TLDSJPWORK/1000base-t1-converter/case/README.md

# 1000BASE-T1コンバーター ケース

125 × 70 mm基板用の上下分割ケースです。
設計外形は132.8 × 77.8 × 28.0 mmです。

## 造形・組立

PLA、0.4 mmノズル、0.2 mm積層で造形しました。
上下ケースはM3×25 mmねじ4本とM3ナット4個で固定します。

上ケースの造形には、ふたの外面を下に配置した
`case-top-print-oriented.stl`を使用してください。
実際に使うねじ・ナットと造形条件で寸法を確認してください。

## ファイル

| ファイル | 用途 |
| --- | --- |
| [case-bottom.stl](case-bottom.stl) | 下ケースの造形 |
| [case-top-print-oriented.stl](case-top-print-oriented.stl) | 上ケースの造形 |
| [case-top.stl](case-top.stl) | 組立時の位置・向きに配置した上ケース形状 |
| [case-bottom.step](case-bottom.step) / [case-top.step](case-top.step) | 他CADでの編集・参照 |

## ライセンス

JP WORKS作成のケース形状をCC BY 4.0で提供します。

第三者の部品参照モデルを含むFreeCADファイル、実装基板STEP、
メーカー由来の部品STEPは、この公開データに含めていません。
