TLDSJPWORK/1000base-t1-converter/production/README.md

# 製造データ

Rev1.0の基板製作に使用したデータです。対応するKiCadソースは[hardware/](../hardware/)にあります。

| ファイル | 内容 |
| --- | --- |
| [1000base-t1-conv.zip](1000base-t1-conv.zip) | Gerber・ドリル出力 |
| [bom.csv](bom.csv) | BOM（部品表） |
| [positions.csv](positions.csv) | 実装位置データ（CPL） |

再製造する場合は、部品指定や未実装部品についての[既知事項](../docs/rev1.0-known-issues.md)を確認してください。
