TLDSJPWORK/1000base-t1-converter/adapter/production/README.md

# MATEnetアダプタ 製造データ

基板Rev1の製造データです。

| ファイル | 内容 |
| --- | --- |
| [Gerber-JLCPCB-rev1.zip](Gerber-JLCPCB-rev1.zip) | Gerber・ドリル出力 |
| [BOM-JLCPCB.csv](BOM-JLCPCB.csv) | JLCPCB実装用部品表。J1のみ |
| [CPL-JLCPCB.csv](CPL-JLCPCB.csv) | J1の実装位置 |

J1はTE Connectivity 2304372-1（LCSC：C5157090）です。J2へのツイストペア線と本体側プラグは手作業で取り付けるため、実装用BOM・位置データには含まれません。

シルクの一部は基板端やソルダーマスク開口に重なる配置です。意図した配置であり、製造時には重なる部分が切り取られます。
