TLDSJPWORK/1000base-t1-converter/production/bom.csv

Designator | Footprint | Quantity | Value | LCSC Part #
C201, C202, C203, C204, C211, C213, C215, C216, C217, C220, C221, C225, C304, C306, C308, C310, C314, C316, C320, C322, C324, C401, C407, C501, C502, C503, C504, C601, C602, C603, C604, C605, C606, C607, C609, C610, C614, C617 | C0603 | 38 | 0.1uF | C14663
C205 | C1206 | 1 | 1kV 4700pF | C9192
C206, C207 | C0603 | 2 | 50V 22pF | C326840
C208, C209, C218, C222, C223, C227, C228, C301, C311, C317 | C0603 | 10 | 10V 10uF | C237435
C210, C224, C302, C312, C318, C405, C406, C608, C611 | C0603 | 9 | 1uF | C15849
C212, C214, C226, C303, C305, C307, C309, C313, C315, C319, C321, C323 | C0603 | 12 | 50V 0.01uF | C57112
C219, C402 | C0603 | 2 | 25V 10uF | C96446
C403, C408, C613 | C0603 | 3 | 2.2uF | C307463
C404, C409 | C0805 | 2 | 47uF | C124129
C505, C612 | C1206 | 2 | 1kV 0.01uF | C107192
C615, C616 | C0603 | 2 | 27pF | C107045
CN201 | CONN-TH_WJ2EDGR-5.08-2P | 1 | WJ2EDGR-5.08-2P | C8383
D401, D403 | SMA_L4.3-W2.6-LS5.2-RD | 2 | B160-13-F | C24784
D402, U201, U202, U204 | LED0603-RD_GREEN | 4 | PSC-1608U52GC-G4 | C22371297
D601 | SOD-123F_L2.8-W1.8-LS3.7-RD | 1 | MBR120VLSFT1G | C223608
J601 | PinSocket_2x20_P2.54mm_Vertical | 1 | Conn_02x20_Counter_Clockwise
J602 | PinHeader_1x03_P2.54mm_Vertical | 1 | Conn_01x03_Pin
L201 | FILTER-SMD_4P-L3.2-W2.5-BL_DLW32SH510XK2L | 1 | DLW32MH201XK2L | C883600
L202, L203, L204, L301, L302, L303 | L0603 | 6 | BLM18KG102BH1D | C560058
L401, L402 | IND-SMD_L7.1-W6.6 | 2 | 15uH | C149585
LED601 | LED0603-RD_GREEN | 1 | TJ-S1608CY6T5ALC7K-A5 | C440520
LED602 | LED0603-RD_RED | 1 | XL-1608SURC-06 | C965799
R201, R202, R207, R209, R212, R213, R301, R614 | R0603 | 8 | 2.2k | C4190
R203, R204, R208, R211, R504 | R0603 | 5 | 2.49k | C22908
R205, R206 | R0603 | 2 | 1.0k 0.25W | C2653986
R210, R505, R607, R613 | R1206 | 4 | 1M 0.25W | C108083
R214, R215, R217, R218, R220, R221, R302, R304, R305, R306, R307, R308, R608, R609 | R0603 | 14 | 22 | C108405
R216 | R0603 | 1 | 100 | C22775
R219, R604 | R0603 | 2 | 10.0k | C25804
R222, R610, R615 | R0603 | 3 | 1k | C21190
R303 | R0603 | 1 | 11k | C137801
R401 | R0603 | 1 | 1.30k | C705951
R402 | R0603 | 1 | 3.40k | C705984
R403 | R0603 | 1 | 4.42k | C728617
R404, R407 | R0603 | 2 | 1.02k | C705819
R405 | R0603 | 1 | 22k | C31850
R406 | R0603 | 1 | 2.26k | C861811
R501 | R0603 | 1 | 5.76k | C23070
R502, R503, R612 | R0603 | 3 | 470 | C23179
R601, R603 | R1206 | 2 | 5.1k | C163372
R602 | R0603 | 1 | 5.6k | C23189
R605, R606 | R0603 | 2 | 27 | C137753
R611 | R0603 | 1 | DNF
RJ501 | RJ45-TH_HR911130A | 1 | HR911130A | C54408
SW601, SW602 | SW-SMD_L6.0-W3.3-LS8.0 | 2 | TS-1101-C-W | C318938
U203, U205 | SW-TH_4P-P2.54_SMQP-02R-TP | 2 | SMQP-02R-TP | C5299482
U206 | UQFN-36_L6.0-W6.0-P0.50-BL-EP3.7 | 1 | DP83TG720RWRHATQ1 | C2921292
U207 | CRYSTAL-SMD_4P-L3.2-W2.5-BL | 1 | ABM8AIG-25.000MHZ-12-2Z-T3 | C1985412
U208 | HVSSOP-8_L3.0-W3.0-P0.65-LS4.9-BL-EP | 1 | TPS7B8233QDGNRQ1 | C5220182
U301 | VQFN-48_L7.0-W7.0-P0.50-BL-EP4.1 | 1 | DP83867ERGZR | C913839
U302, U303 | C0603 | 2 | 25V 27pF | C1656
U401, U403 | SOT-23-6_L2.9-W1.6-P0.95-LS2.8-BR | 2 | LMR14206XMKX/NOPB | C48239
U402 | VSON-10_L3.0-W3.0-P0.50-TL-EP | 1 | TPS74701DRCR | C105262
U601 | LQFN-56_L7.0-W7.0-P0.4-EP | 1 | RP2040 | C2040
U602 | USON-8_L3.0-W2.0-P0.50-BL-EP | 1 | W25Q16JVUXIQ | C2843335
U603 | CRYSTAL-SMD_L11.5-W4.8-LS12.7 | 1 | ABLS-12.000MHZ-B4-T | C596818
U604 | SOT-23-5_L2.9-W1.6-P0.95-LS2.8-BR | 1 | TPS3838K33QDBVRQ1 | C702198
USB601 | USB-C-SMD_TYPE-C-6PIN-2MD-073 | 1 | TYPE-C 16PIN 2MD(073) | C2765186
X301 | OSC-SMD_L5.0-W3.2 | 1 | NX5032GA-25.000M-STD-CSK-4 | C115092
