TLDSJPWORK/1000base-t1-converter/adapter/production/BOM-JLCPCB.csv

Comment | Designator | Footprint | LCSC Part #
TE 2304372-1 | J1 | TE_MATEnet_2304372-1_C5157090 | C5157090
