TLDSJPWORK/1000base-t1-converter/adapter/case/case-top-print-oriented.stl

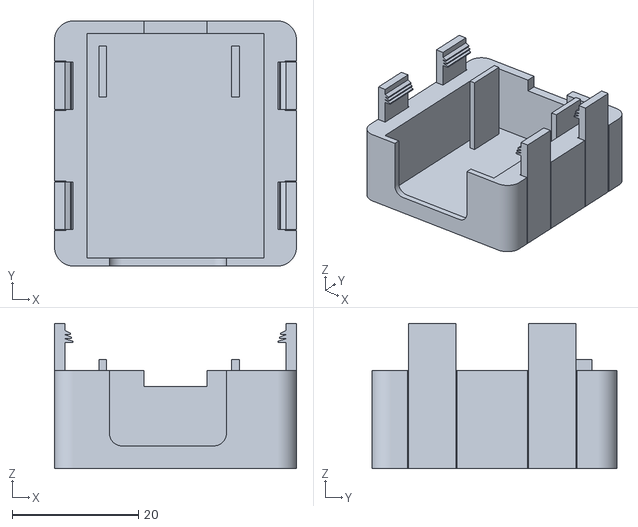
[picture p7: CAD file, 2026-10-27]
adapter/case/case-top-print-oriented.stl
38.3 x 38.8 x 23.0
