TLDSJPWORK/1000base-t1-converter/case/case-bottom.step

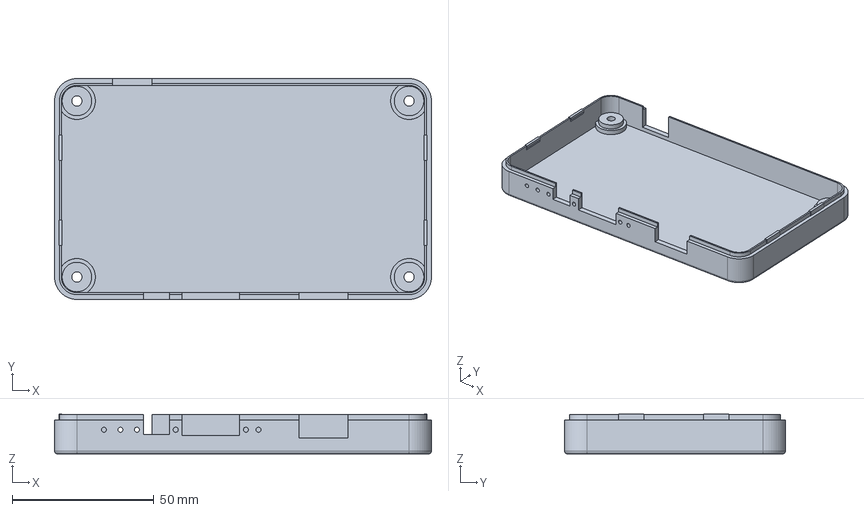
[picture p8: CAD file, 2026-10-27]
case/case-bottom.step
132.8 x 77.8 x 14.0 mm
