TLDSJPWORK/1000base-t1-converter/case/case-top-print-oriented.stl

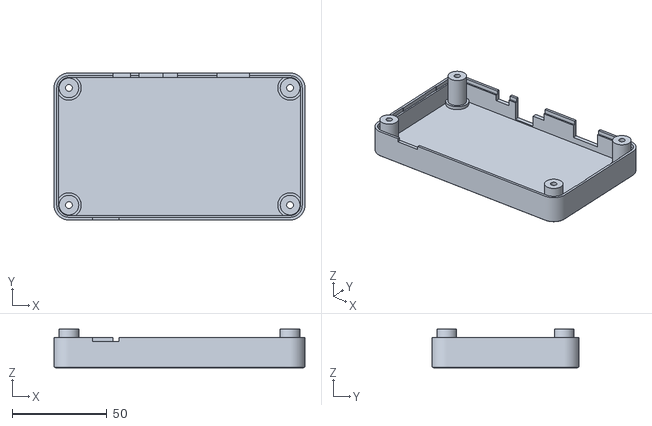
[picture p9: CAD file, 2026-10-27]
case/case-top-print-oriented.stl
132.8 x 77.8 x 20.4
