TLDSJPWORK/1000base-t1-converter/adapter/case/case-bottom.step

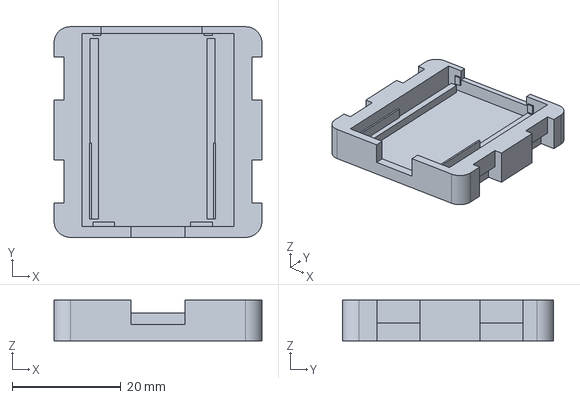
[picture p10: CAD file, 2026-10-27]
adapter/case/case-bottom.step
38.3 x 38.8 x 7.50 mm
