TLDSJPWORK/1000base-t1-converter/(list of files, cad)

Other CAD files:
adapter/case/case-top.step
case/case-top.step
adapter/case/case-bottom.stl
adapter/case/case-top.stl
case/case-bottom.stl
case/case-top.stl
