TLDSJPWORK/1000base-t1-converter/docs/1000base-t1-converter_schematic.pdf

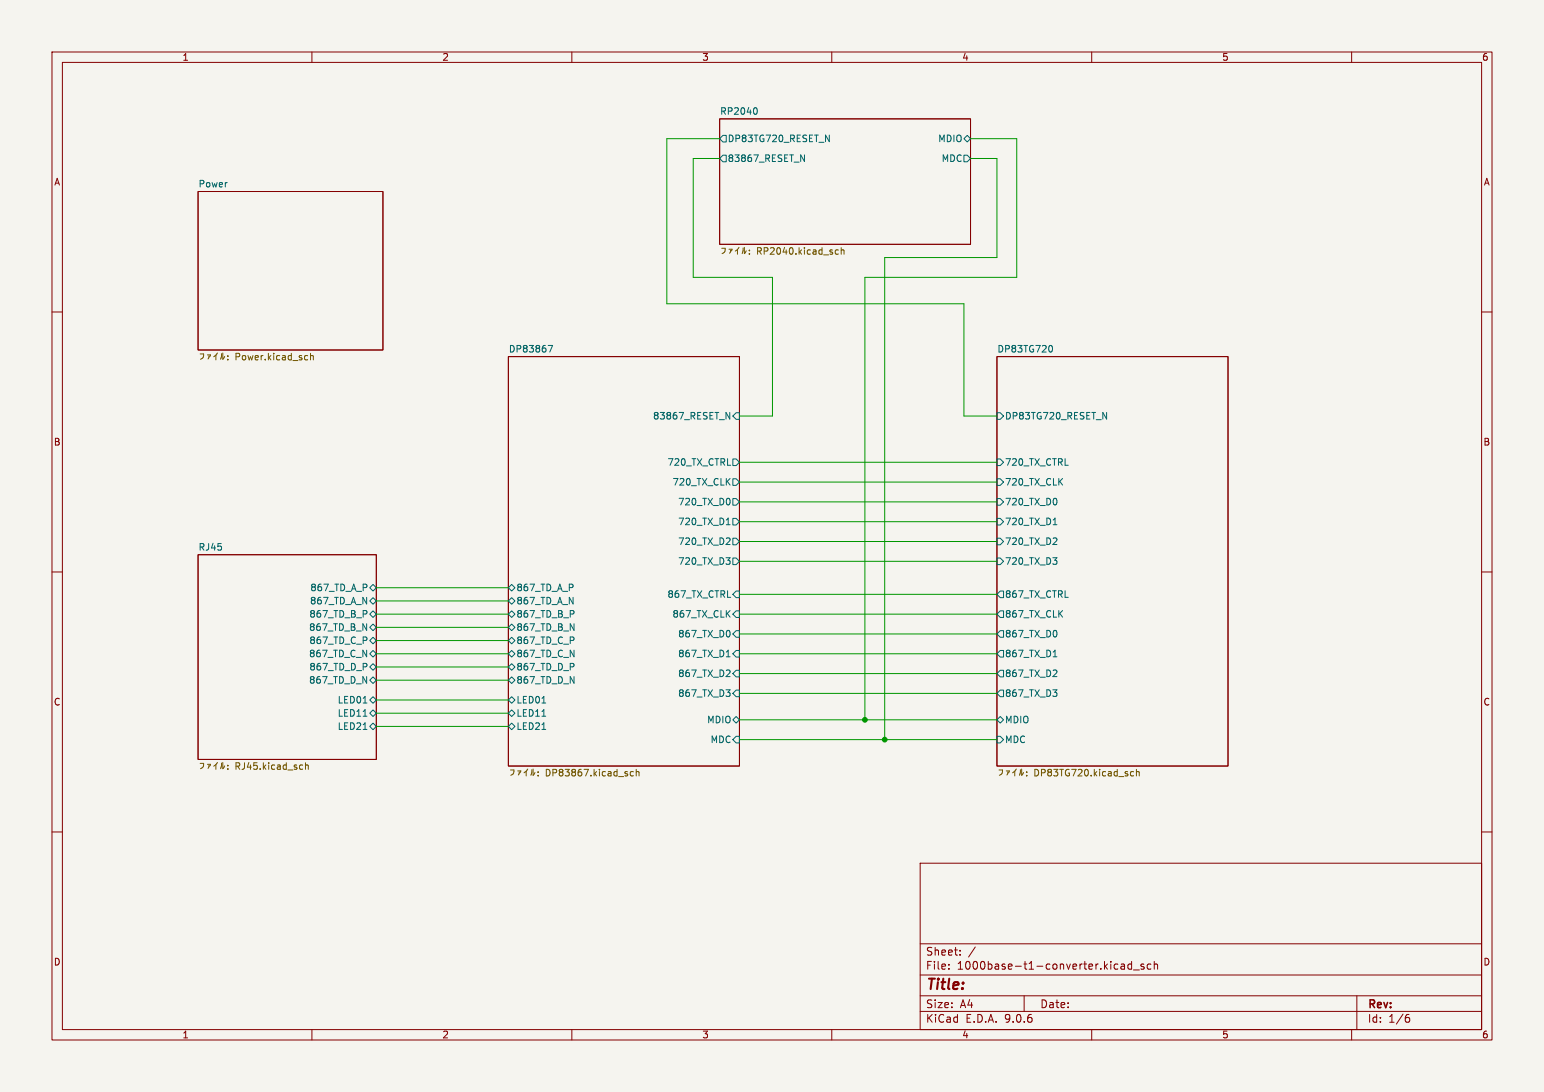
[picture p11: page 1]

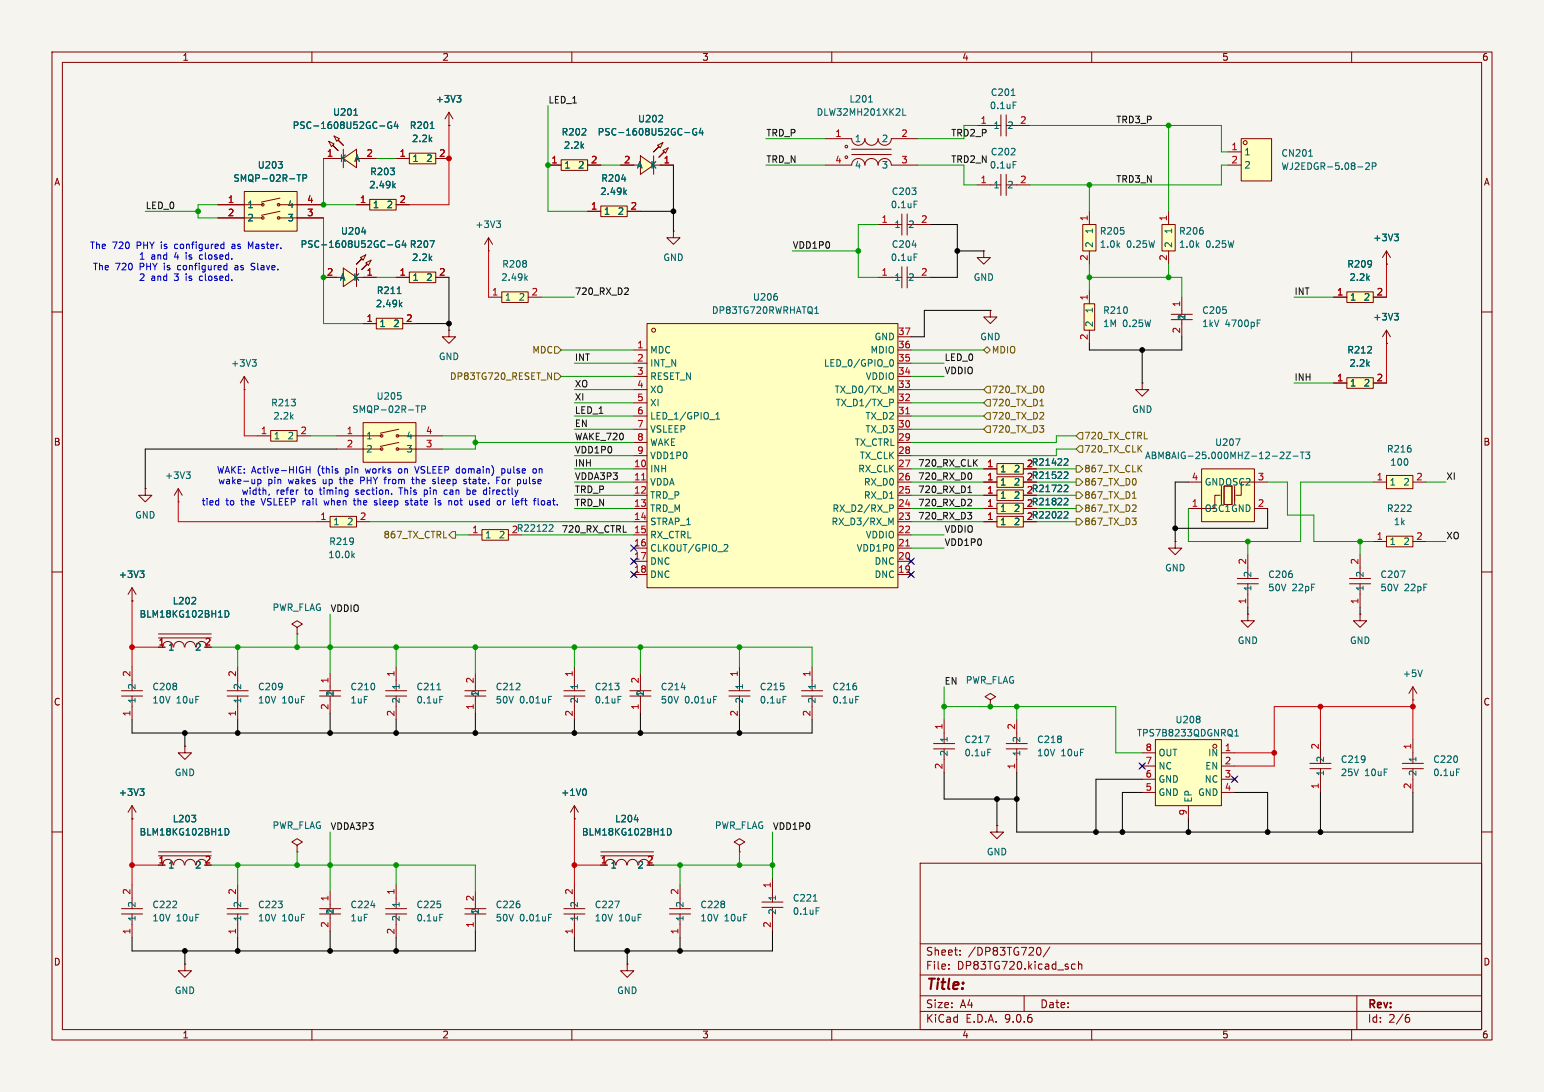
[picture p12: page 2]

LED_0/GPIO_0 35 VDDIO 34 TX_D0/TX_M 33 TX_D1/TX_P 32 TX_D2 31 TX_D3 30 TX_CTRL 29 TX_CLK 28 RX_CLK 27 RX_D0 26 RX_D1 25 RX_D2/RX_P 24 RX_D3/RX_M 23 VDDIO 22 VDD1P0 21 DNC 20 DNC 19 U206 DP83TG720RWRHATQ1

9 OUT 8 NC 7 GND 6 GND 5 U208 TPS7B8233QDGNRQ1

IN 1 EN 2 NC 3 GND 4 EP

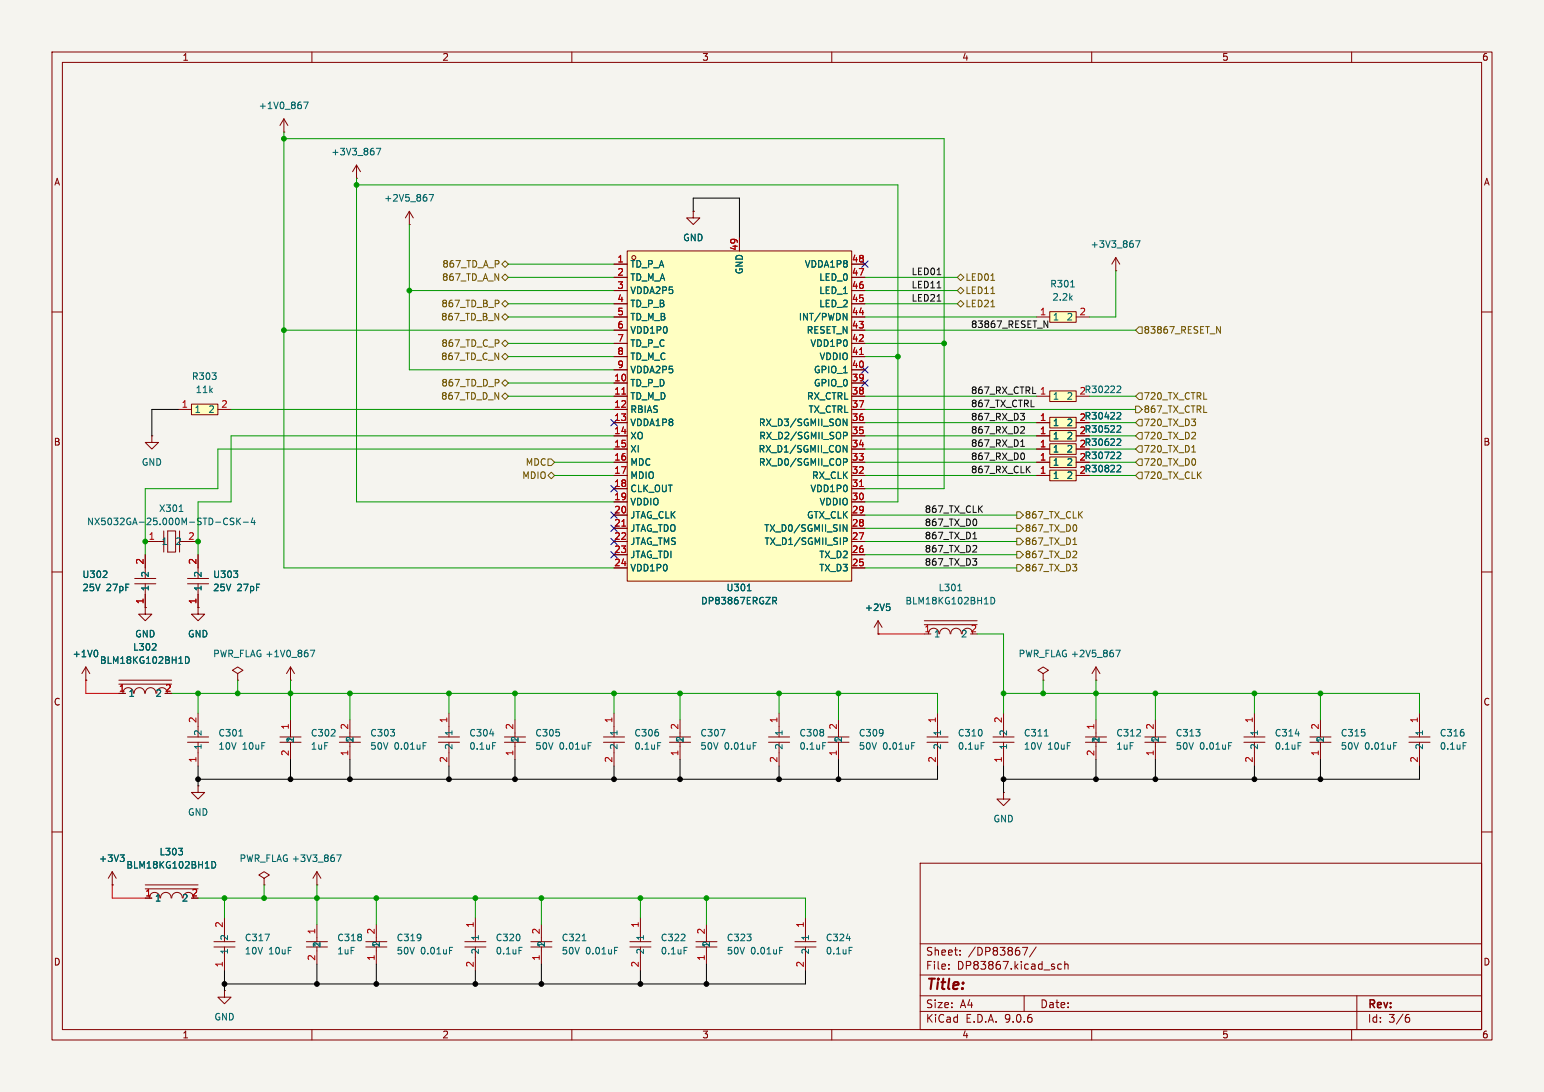
[picture p13: page 3]

GND
TD_P_A 1 TD_M_A 2 VDDA2P5 3 TD_P_B 4 TD_M_B 5 VDD1P0 6 TD_P_C 7 TD_M_C 8 VDDA2P5 9 TD_P_D 10 TD_M_D 11 RBIAS 12 VDDA1P8 13 XO 14 XI 15 MDC 16 MDIO 17 CLK_OUT 18 VDDIO 19

INT/PWDN 44 RESET_N 43 VDD1P0 42 VDDIO 41 GPIO_1 40 GPIO_0 39 RX_CTRL 38 TX_CTRL 37 RX_D3/SGMII_SON 36 RX_D2/SGMII_SOP 35 RX_D1/SGMII_CON 34 RX_D0/SGMII_COP 33 RX_CLK 32 VDD1P0 31 VDDIO 30 GTX_CLK 29 TX_D0/SGMII_SIN 28 TX_D1/SGMII_SIP 27 TX_D2 26 TX_D3 25 GND

INT/PWDN 44 RESET_N 43 VDD1P0 42 VDDIO 41 GPIO_1 40 GPIO_0 39 RX_CTRL 38 TX_CTRL 37 RX_D3/SGMII_SON 36 RX_D2/SGMII_SOP 35 RX_D1/SGMII_CON 34 RX_D0/SGMII_COP 33 RX_CLK 32 VDD1P0 31 VDDIO 30 GTX_CLK 29 TX_D0/SGMII_SIN 28 TX_D1/SGMII_SIP 27 TX_D2 26 TX_D3 25 U301 DP83867ERGZR GND

Id: 3/6 Title: File: DP83867.kicad_sch Sheet: /DP83867/

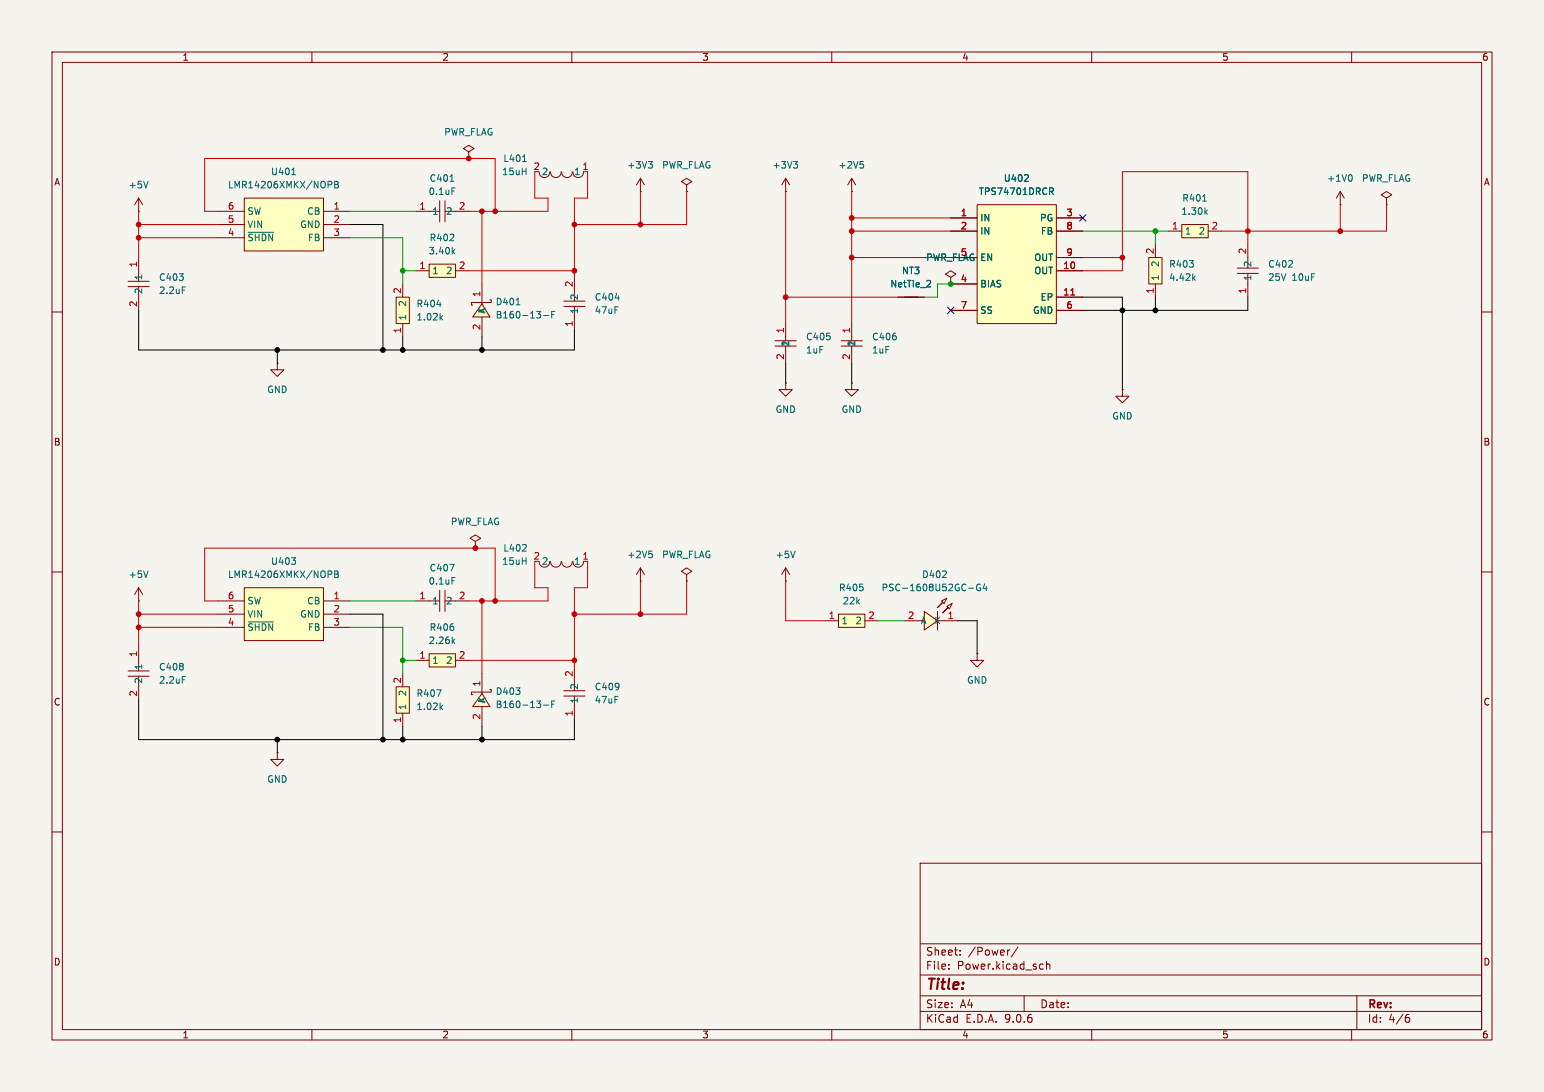
[picture p14: page 4]

Id: 4/6 Title: File: Power.kicad_sch Sheet: /Power/ 1

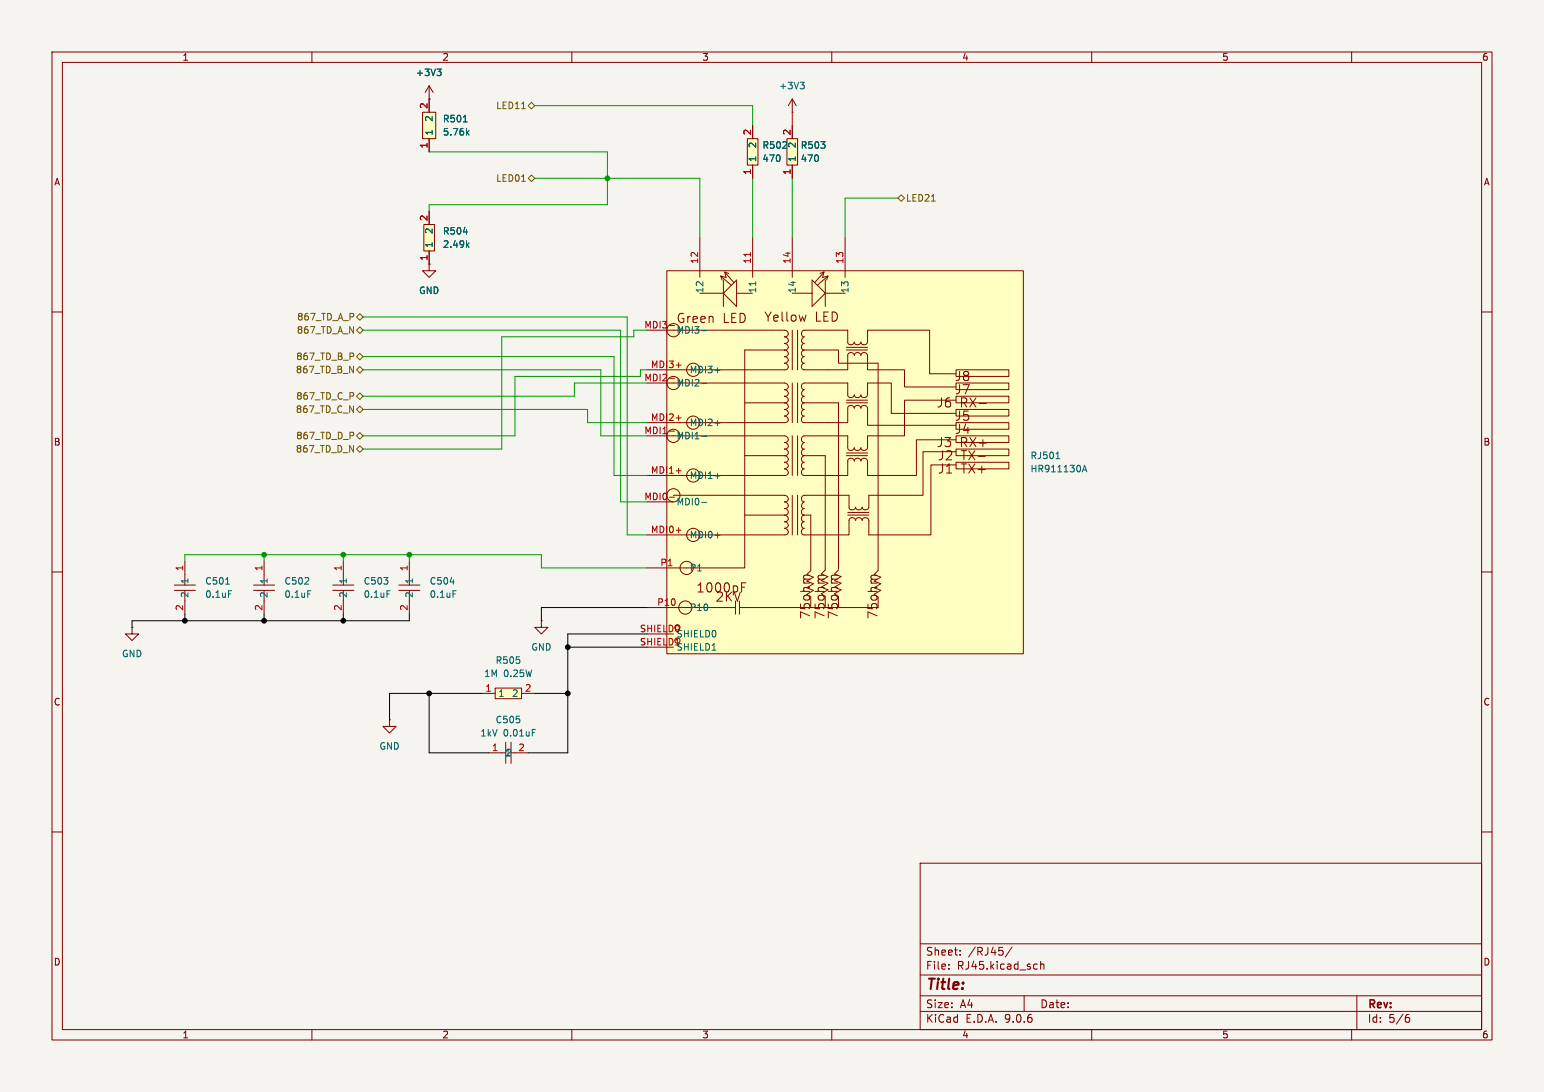
[picture p15: page 5]

Id: 5/6 Title: File: RJ45.kicad_sch Sheet: /RJ45/

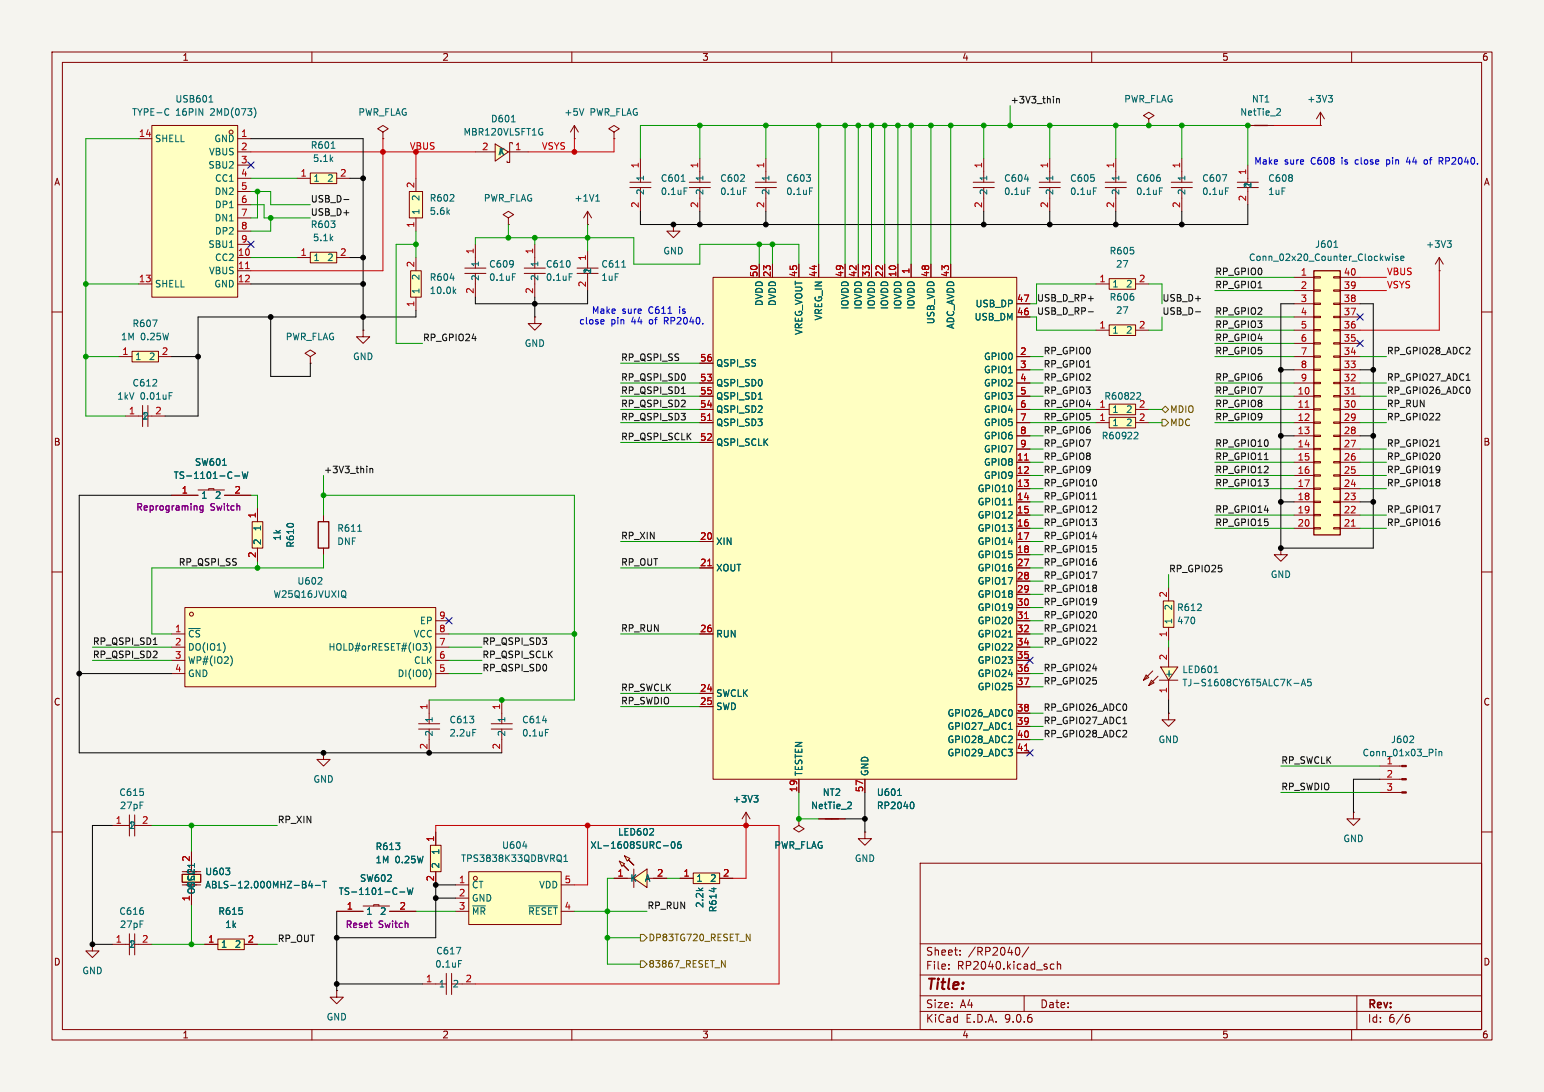
[picture p16: page 6]

Make sure C608 is close pin 44 of RP2040. Make sure C611 is

Id: 6/6 Title: File: RP2040.kicad_sch Sheet: /RP2040/
