TLDSJPWORK/1000base-t1-converter/hardware/1000base-t1-converter.kicad_pcb

## KiCad design hardware/1000base-t1-converter.kicad_pcb (2026-10-04)

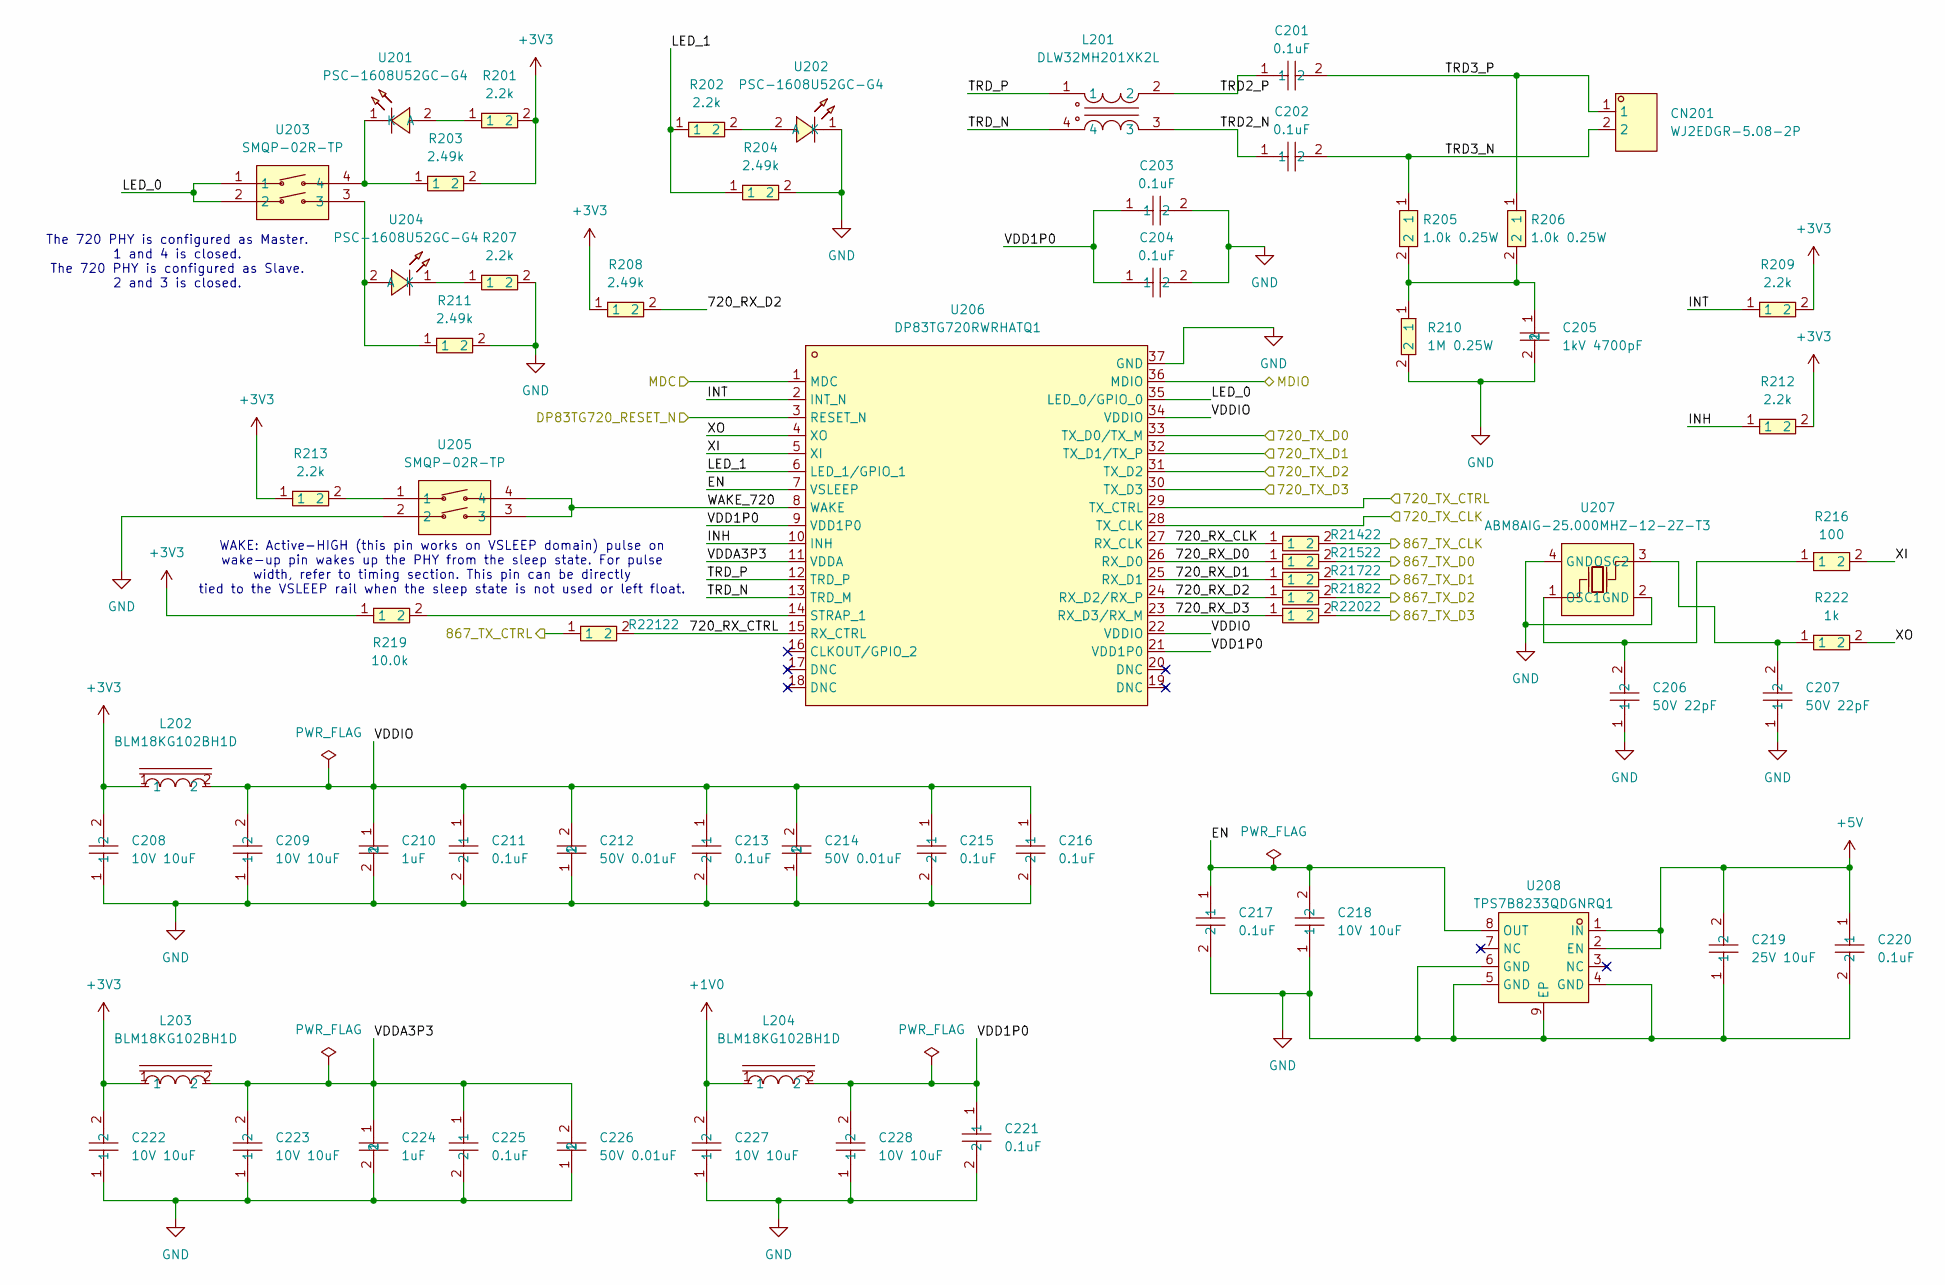
[picture p17: schematic DP83TG720.kicad_sch]

Parts:
C201, C202, C203, C204, C211, C213, C215, C216, C217, C220, C221, C225: 0.1uF; C0603; LCSC Part C14663
C205: 1kV 4700pF; C1206; LCSC Part C9192
C206, C207: 50V 22pF; C0603; LCSC Part C326840
C208, C209, C218, C222, C223, C227, C228: 10V 10uF; C0603; MPN GRM188Z71A106MA73D; LCSC Part C237435
C210, C224: 1uF; C0603; LCSC Part C15849
C212, C214, C226: 50V 0.01uF; C0603; LCSC Part C57112
C219: 25V 10uF; C0603; LCSC Part C96446
CN201: WJ2EDGR-5.08-2P; CONN-TH_WJ2EDGR-5.08-2P; MPN WJ2EDGR-5.08-02P-14-00A; LCSC Part C8383
L201: DLW32MH201XK2L; FILTER-SMD_4P-L3.2-W2.5-BL_DLW32SH510XK2L; MPN DLW32MH201XK2L; LCSC Part C883600
L202, L203, L204: BLM18KG102BH1D; L0603; MPN BLM18KG102BH1D; LCSC Part C560058
R201, R202, R207, R209, R212, R213: 2.2k; R0603; LCSC Part C4190
R203, R204, R208, R211: 2.49k; R0603; LCSC Part C22908
R205, R206: 1.0k 0.25W; R0603; LCSC Part C2653986
R210: 1M 0.25W; R1206; LCSC Part C108083
R214, R215, R217, R218, R220, R221: 22; R0603; LCSC Part C108405
R216: 100; R0603; LCSC Part C22775
R219: 10.0k; R0603; LCSC Part C25804
R222: 1k; R0603; LCSC Part C21190
U201, U202, U204: PSC-1608U52GC-G4; LED0603-RD_GREEN; LCSC Part C22371297
U203, U205: SMQP-02R-TP; SW-TH_4P-P2.54_SMQP-02R-TP; LCSC Part C5299482
U206: DP83TG720RWRHATQ1; UQFN-36_L6.0-W6.0-P0.50-BL-EP3.7; MPN DP83TG720RWRHATQ1; LCSC Part C2921292
U207: ABM8AIG-25.000MHZ-12-2Z-T3; CRYSTAL-SMD_4P-L3.2-W2.5-BL; MPN ABM8AIG-25.000MHZ-12-2Z-T3; LCSC Part C1985412
U208: TPS7B8233QDGNRQ1; HVSSOP-8_L3.0-W3.0-P0.65-LS4.9-BL-EP; MPN TPS7B8233QDGNRQ1; LCSC Part C5220182

Connections:
+1V0: C227.2, L204.1; also elsewhere on the board
+3V3: C208.2, C222.2, L202.1, L203.1, R201.2, R203.2, R208.1, R209.2, R212.2, R213.1, R219.1; also elsewhere on the board
+5V: C219.2, C220.1, U208.1 (IN), U208.2 (EN); also elsewhere on the board
/DP83TG720/720_RX_CLK: R214.1, U206.27 (RX_CLK)
/DP83TG720/720_RX_CTRL: R221.2, U206.15 (RX_CTRL)
/DP83TG720/720_RX_D0: R215.1, U206.26 (RX_D0)
/DP83TG720/720_RX_D1: R217.1, U206.25 (RX_D1)
/DP83TG720/720_RX_D2: R208.2, R218.1, U206.24 (RX_D2/RX_P)
/DP83TG720/720_RX_D3: R220.1, U206.23 (RX_D3/RX_M)
/DP83TG720/EN: C217.1, C218.2, U206.7 (VSLEEP), U208.8 (OUT)
/DP83TG720/INH: R212.1, U206.10 (INH)
/DP83TG720/INT: R209.1, U206.2 (INT_N)
/DP83TG720/LED_0: U203.1, U203.2, U206.35 (LED_0/GPIO_0)
/DP83TG720/LED_1: R202.1, R204.1, U206.6 (LED_1/GPIO_1)
/DP83TG720/TRD2_N: C202.1, L201.3
/DP83TG720/TRD2_P: C201.1, L201.2
/DP83TG720/TRD3_N: C202.2, CN201.2, R205.1
/DP83TG720/TRD3_P: C201.2, CN201.1, R206.1
/DP83TG720/TRD_N: L201.4, U206.13 (TRD_M)
/DP83TG720/TRD_P: L201.1, U206.12 (TRD_P)
/DP83TG720/VDD1P0: C203.1, C204.1, C221.1, C228.2, L204.2, U206.9 (VDD1P0), U206.21 (VDD1P0)
/DP83TG720/VDDA3P3: C223.2, C224.1, C225.1, C226.2, L203.2, U206.11 (VDDA)
/DP83TG720/VDDIO: C209.2, C210.1, C211.1, C212.2, C213.1, C214.2, C215.1, C216.1, L202.2, U206.22 (VDDIO), U206.34 (VDDIO)
/DP83TG720/WAKE_720: U205.3, U205.4, U206.8 (WAKE)
/DP83TG720/XI: R216.2, U206.5 (XI)
/DP83TG720/XO: R222.2, U206.4 (XO)
/DP83867/720_TX_CLK: U206.28 (TX_CLK); also elsewhere on the board
/DP83867/720_TX_CTRL: U206.29 (TX_CTRL); also elsewhere on the board
/DP83867/720_TX_D0: U206.33 (TX_D0/TX_M); also elsewhere on the board
/DP83867/720_TX_D1: U206.32 (TX_D1/TX_P); also elsewhere on the board
/DP83867/720_TX_D2: U206.31 (TX_D2); also elsewhere on the board
/DP83867/720_TX_D3: U206.30 (TX_D3); also elsewhere on the board
/DP83867/867_TX_CLK: R214.2; also elsewhere on the board
/DP83867/867_TX_CTRL: R221.1; also elsewhere on the board
/DP83867/867_TX_D0: R215.2; also elsewhere on the board
/DP83867/867_TX_D1: R217.2; also elsewhere on the board
/DP83867/867_TX_D2: R218.2; also elsewhere on the board
/DP83867/867_TX_D3: R220.2; also elsewhere on the board
/DP83867/83867_RESET_N: U206.3 (RESET_N); also elsewhere on the board
/DP83867/MDC: U206.1 (MDC); also elsewhere on the board
/DP83867/MDIO: U206.36 (MDIO); also elsewhere on the board
GND: C203.2, C204.2, C205.2, C206.1, C207.1, C208.1, C209.1, C210.2, C211.2, C212.1, C213.2, C214.1, C215.2, C216.2, C217.2, C218.1, C219.1, C220.2, C221.2, C222.1, C223.1, C224.2, C225.2, C226.1, C227.1, C228.1, R204.2, R207.2, R210.2, R211.2, U202.1 (K), U205.2, U206.37 (GND), U207.2 (GND), U207.4 (GND), U208.4 (GND), U208.5 (GND), U208.6 (GND), U208.9 (EP); also elsewhere on the board
unnamed: C205.1, R205.2, R206.2, R210.1
unnamed: R213.2, U205.1
unnamed: R201.1, U201.2 (A)
unnamed: R203.1, U201.1 (K), U203.4
unnamed: R202.2, U202.2 (A)
unnamed: R211.1, U203.3, U204.2 (A)
unnamed: R207.1, U204.1 (K)
unnamed: R219.2, U206.14 (STRAP_1)
unnamed: C206.2, R216.1, U207.1 (OSC1)
unnamed: C207.2, R222.1, U207.3 (OSC2)

Notes on the sheet:
The 720 PHY is configured as Master. 1 and 4 is closed. The 720 PHY is configured as Slave. 2 and 3 is closed.
WAKE: Active-HIGH (this pin works on VSLEEP domain) pulse on wake-up pin wakes up the PHY from the sleep state. For pulse width, refer to timing section. This pin can be directly tied to the VSLEEP rail when the sleep state is not used or left float.

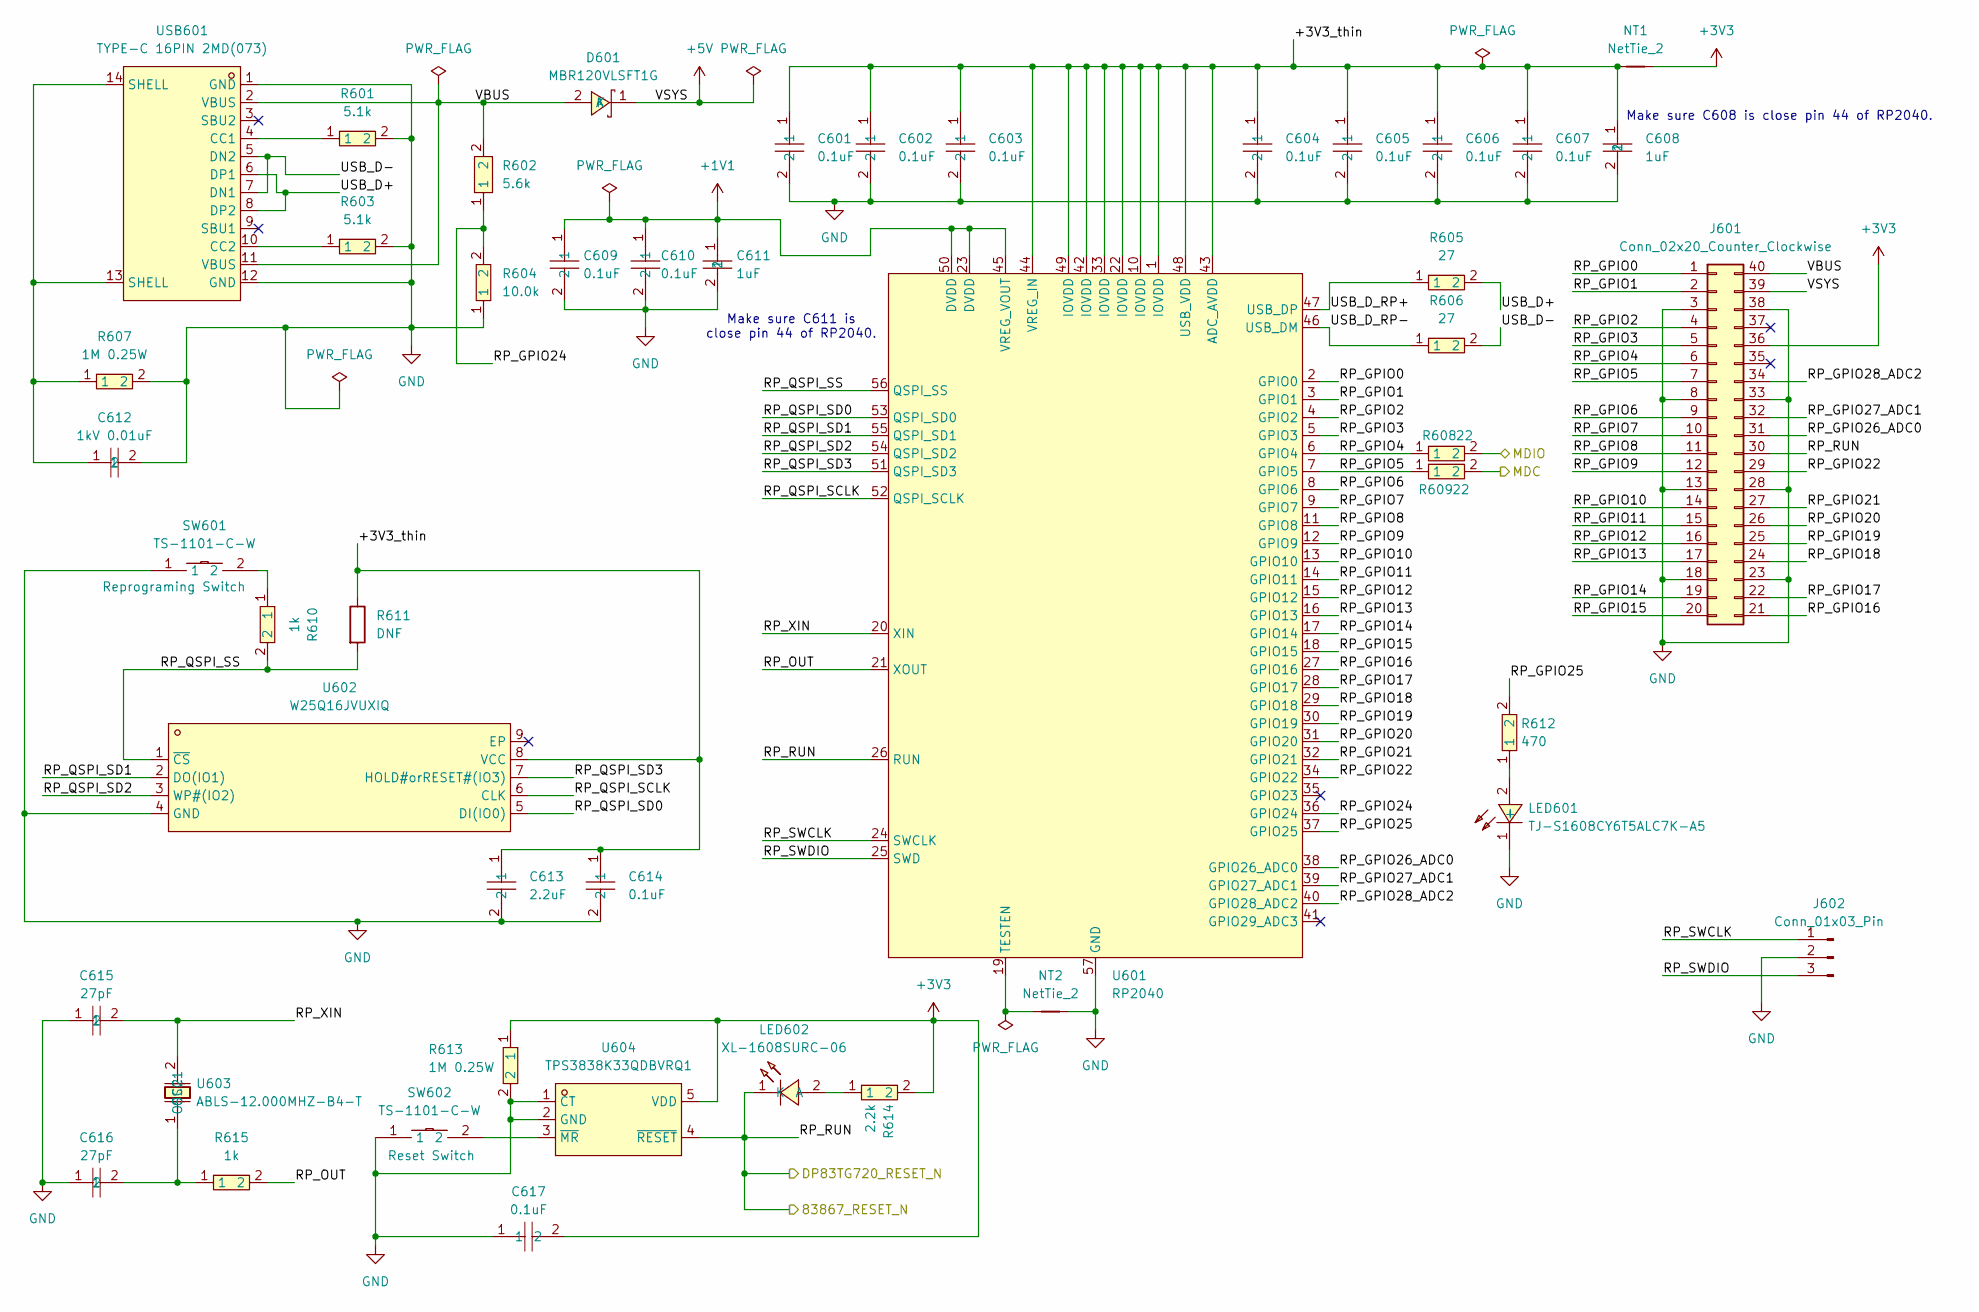
[picture p18: schematic RP2040.kicad_sch]

Parts:
C601, C602, C603, C604, C605, C606, C607, C609, C610, C614, C617: 0.1uF; C0603; LCSC Part C14663
C608, C611: 1uF; C0603; LCSC Part C15849
C612: 1kV 0.01uF; C1206; LCSC Part C107192
C613: 2.2uF; C0603; LCSC Part C307463
C615, C616: 27pF; C0603; LCSC Part C107045
D601: MBR120VLSFT1G; SOD-123F_L2.8-W1.8-LS3.7-RD; LCSC Part C223608
J601: Conn_02x20_Counter_Clockwise; PinSocket_2x20_P2.54mm_Vertical
J602: Conn_01x03_Pin; PinHeader_1x03_P2.54mm_Vertical
LED601: TJ-S1608CY6T5ALC7K-A5; LED0603-RD_GREEN; LCSC Part C440520
LED602: XL-1608SURC-06; LED0603-RD_RED; LCSC Part C965799
NT1, NT2: NetTie_2; NetTie-2_SMD_Pad0.5mm
R601, R603: 5.1k; R1206; LCSC Part C163372
R602: 5.6k; R0603; LCSC Part C23189
R604: 10.0k; R0603; LCSC Part C25804
R605, R606: 27; R0603; LCSC Part C137753
R607, R613: 1M 0.25W; R1206; LCSC Part C108083
R608, R609: 22; R0603; LCSC Part C108405
R610, R615: 1k; R0603; LCSC Part C21190
R611: DNF; R0603
R612: 470; R0603; LCSC Part C23179
R614: 2.2k; R0603; LCSC Part C4190
SW601, SW602: TS-1101-C-W; SW-SMD_L6.0-W3.3-LS8.0; LCSC Part C318938
U601: RP2040; LQFN-56_L7.0-W7.0-P0.4-EP; LCSC Part C2040
U602: W25Q16JVUXIQ; USON-8_L3.0-W2.0-P0.50-BL-EP; LCSC Part C2843335
U603: ABLS-12.000MHZ-B4-T; CRYSTAL-SMD_L11.5-W4.8-LS12.7; LCSC Part C596818
U604: TPS3838K33QDBVRQ1; SOT-23-5_L2.9-W1.6-P0.95-LS2.8-BR; LCSC Part C702198
USB601: TYPE-C 16PIN 2MD(073); USB-C-SMD_TYPE-C-6PIN-2MD-073; LCSC Part C2765186

Connections:
+1V1: C609.1, C610.1, C611.1, U601.23 (DVDD), U601.45 (VREG_VOUT), U601.50 (DVDD)
+3V3: C617.2, J601.36, NT1.2, R613.1, R614.2, U604.5 (VDD); also elsewhere on the board
+5V: D601.1 (K), J601.39; also elsewhere on the board
/DP83867/83867_RESET_N: J601.30, LED602.1 (K), U601.26 (RUN), U604.4 (~RESET); also elsewhere on the board
/DP83867/MDC: R609.2; also elsewhere on the board
/DP83867/MDIO: R608.2; also elsewhere on the board
/RP2040/+3V3_thin: C601.1, C602.1, C603.1, C604.1, C605.1, C606.1, C607.1, C608.1, C613.1, C614.1, NT1.1, R611.1, U601.1 (IOVDD), U601.10 (IOVDD), U601.22 (IOVDD), U601.33 (IOVDD), U601.42 (IOVDD), U601.43 (ADC_AVDD), U601.44 (VREG_IN), U601.48 (USB_VDD), U601.49 (IOVDD), U602.8 (VCC)
/RP2040/RP_GPIO0: J601.1, U601.2 (GPIO0)
/RP2040/RP_GPIO1: J601.2, U601.3 (GPIO1)
/RP2040/RP_GPIO2: J601.4, U601.4 (GPIO2)
/RP2040/RP_GPIO3: J601.5, U601.5 (GPIO3)
/RP2040/RP_GPIO4: J601.6, R608.1, U601.6 (GPIO4)
/RP2040/RP_GPIO5: J601.7, R609.1, U601.7 (GPIO5)
/RP2040/RP_GPIO6: J601.9, U601.8 (GPIO6)
/RP2040/RP_GPIO7: J601.10, U601.9 (GPIO7)
/RP2040/RP_GPIO8: J601.11, U601.11 (GPIO8)
/RP2040/RP_GPIO9: J601.12, U601.12 (GPIO9)
/RP2040/RP_GPIO10: J601.14, U601.13 (GPIO10)
/RP2040/RP_GPIO11: J601.15, U601.14 (GPIO11)
/RP2040/RP_GPIO12: J601.16, U601.15 (GPIO12)
/RP2040/RP_GPIO13: J601.17, U601.16 (GPIO13)
/RP2040/RP_GPIO14: J601.19, U601.17 (GPIO14)
/RP2040/RP_GPIO15: J601.20, U601.18 (GPIO15)
/RP2040/RP_GPIO16: J601.21, U601.27 (GPIO16)
/RP2040/RP_GPIO17: J601.22, U601.28 (GPIO17)
/RP2040/RP_GPIO18: J601.24, U601.29 (GPIO18)
/RP2040/RP_GPIO19: J601.25, U601.30 (GPIO19)
/RP2040/RP_GPIO20: J601.26, U601.31 (GPIO20)
/RP2040/RP_GPIO21: J601.27, U601.32 (GPIO21)
/RP2040/RP_GPIO22: J601.29, U601.34 (GPIO22)
/RP2040/RP_GPIO24: R602.1, R604.2, U601.36 (GPIO24)
/RP2040/RP_GPIO25: R612.2, U601.37 (GPIO25)
/RP2040/RP_GPIO26_ADC0: J601.31, U601.38 (GPIO26_ADC0)
/RP2040/RP_GPIO27_ADC1: J601.32, U601.39 (GPIO27_ADC1)
/RP2040/RP_GPIO28_ADC2: J601.34, U601.40 (GPIO28_ADC2)
/RP2040/RP_OUT: R615.2, U601.21 (XOUT)
/RP2040/RP_QSPI_SCLK: U601.52 (QSPI_SCLK), U602.6 (CLK)
/RP2040/RP_QSPI_SD0: U601.53 (QSPI_SD0), U602.5 (DI(IO0))
/RP2040/RP_QSPI_SD1: U601.55 (QSPI_SD1), U602.2 (DO(IO1))
/RP2040/RP_QSPI_SD2: U601.54 (QSPI_SD2), U602.3 (WP#(IO2))
/RP2040/RP_QSPI_SD3: U601.51 (QSPI_SD3), U602.7 (HOLD#orRESET#(IO3))
/RP2040/RP_QSPI_SS: R610.2, R611.2, U601.56 (QSPI_SS), U602.1 (~CS)
/RP2040/RP_SWCLK: J602.1, U601.24 (SWCLK)
/RP2040/RP_SWDIO: J602.3, U601.25 (SWD)
/RP2040/RP_XIN: C615.2, U601.20 (XIN), U603.2 (OSC2)
/RP2040/USB_D+: R605.2, USB601.6 (DP1), USB601.8 (DP2)
/RP2040/USB_D-: R606.2, USB601.5 (DN2), USB601.7 (DN1)
/RP2040/USB_D_RP+: R605.1, U601.47 (USB_DP)
/RP2040/USB_D_RP-: R606.1, U601.46 (USB_DM)
/RP2040/VBUS: D601.2 (A), J601.40, R602.2, USB601.2 (VBUS), USB601.11 (VBUS)
GND: C601.2, C602.2, C603.2, C604.2, C605.2, C606.2, C607.2, C608.2, C609.2, C610.2, C611.2, C612.2, C613.2, C614.2, C615.1, C616.1, C617.1, J601.3, J601.8, J601.13, J601.18, J601.23, J601.28, J601.33, J601.38, J602.2, LED601.1 (-), NT2.2, R601.2, R603.2, R604.1, R607.2, R613.2, SW601.1, SW602.1, U601.57 (GND), U602.4 (GND), U604.1 (CT), U604.2 (GND), USB601.1 (GND), USB601.12 (GND); also elsewhere on the board
unnamed: C612.1, R607.1, USB601.13 (SHELL), USB601.14 (SHELL)
unnamed: LED601.2 (+), R612.1
unnamed: LED602.2 (A), R614.1
unnamed: R610.1, SW601.2
unnamed: NT2.1, U601.19 (TESTEN)
unnamed: C616.2, R615.1, U603.1 (OSC1)
unnamed: SW602.2, U604.3 (~MR)
unnamed: R601.1, USB601.4 (CC1)
unnamed: R603.1, USB601.10 (CC2)

Notes on the sheet:
Make sure C608 is close pin 44 of RP2040.
Make sure C611 is close pin 44 of RP2040.

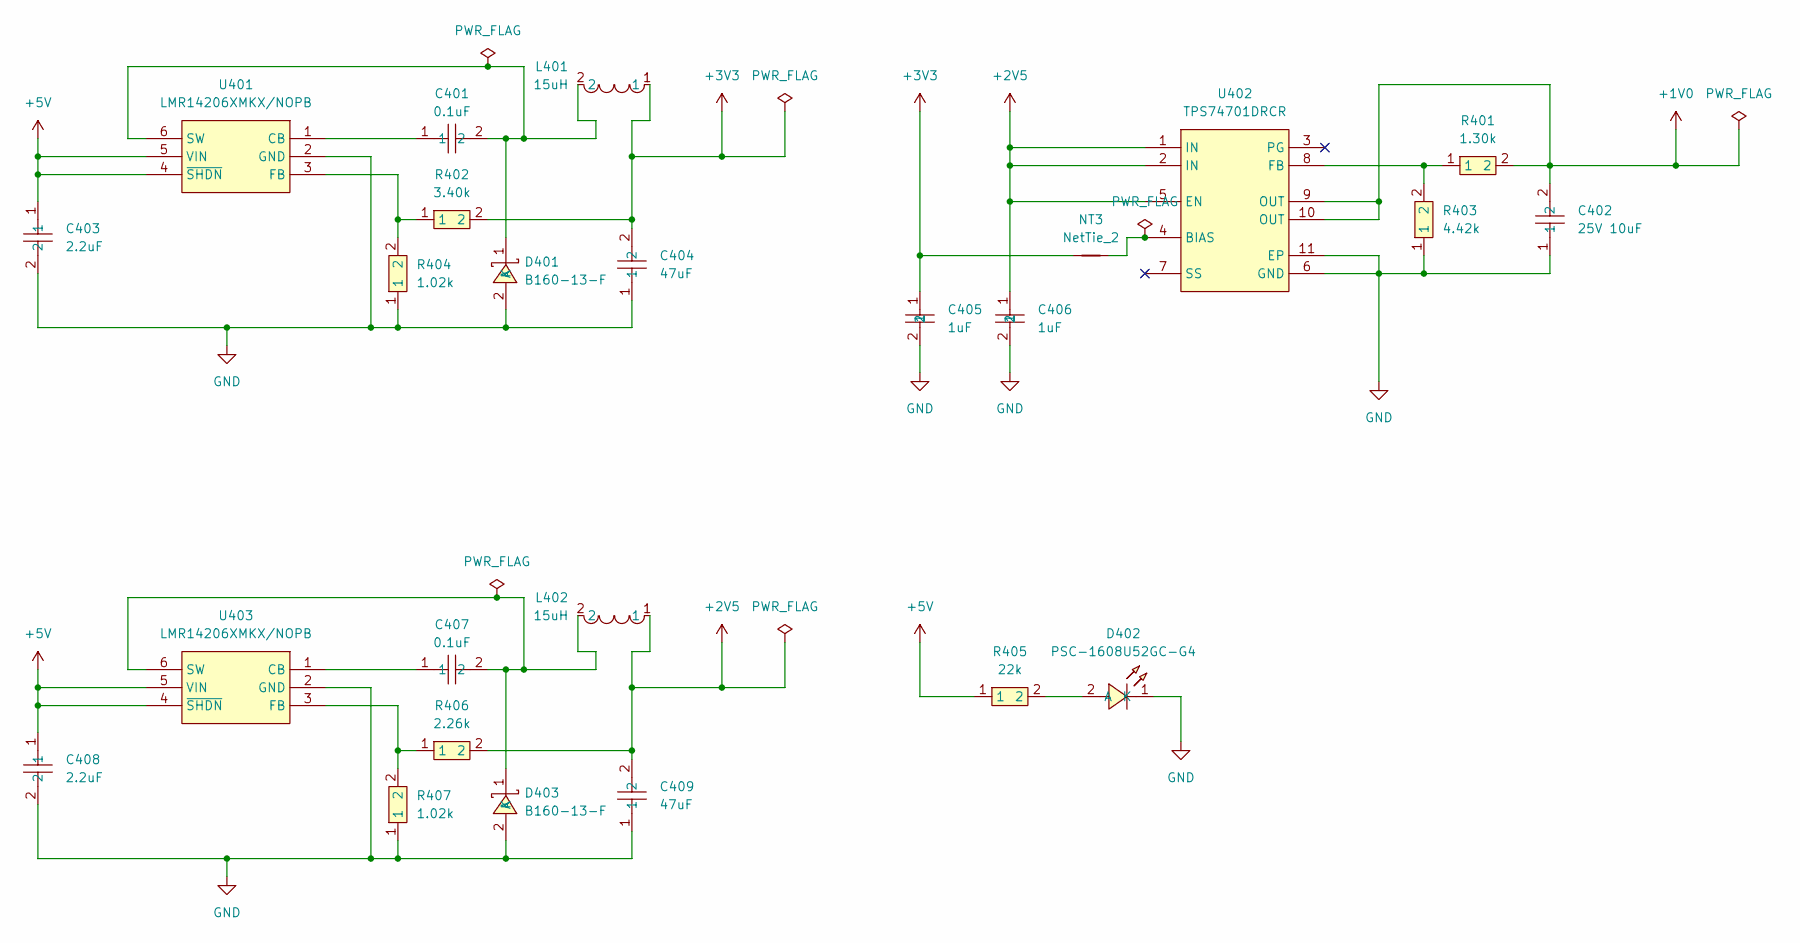
[picture p19: schematic Power.kicad_sch]

Parts:
C401, C407: 0.1uF; C0603; LCSC Part C14663
C402: 25V 10uF; C0603; LCSC Part C96446
C403, C408: 2.2uF; C0603; LCSC Part C307463
C404, C409: 47uF; C0805; LCSC Part C124129
C405, C406: 1uF; C0603; LCSC Part C15849
D401, D403: B160-13-F; SMA_L4.3-W2.6-LS5.2-RD; LCSC Part C24784
D402: PSC-1608U52GC-G4; LED0603-RD_GREEN; LCSC Part C22371297
L401, L402: 15uH; IND-SMD_L7.1-W6.6; LCSC Part C149585
NT3: NetTie_2; NetTie-2_SMD_Pad0.5mm
R401: 1.30k; R0603; LCSC Part C705951
R402: 3.40k; R0603; LCSC Part C705984
R403: 4.42k; R0603; LCSC Part C728617
R404, R407: 1.02k; R0603; LCSC Part C705819
R405: 22k; R0603; LCSC Part C31850
R406: 2.26k; R0603; LCSC Part C861811
U401, U403: LMR14206XMKX/NOPB; SOT-23-6_L2.9-W1.6-P0.95-LS2.8-BR; LCSC Part C48239
U402: TPS74701DRCR; VSON-10_L3.0-W3.0-P0.50-TL-EP; MPN TPS74701DRCR; LCSC Part C105262

Connections:
+1V0: C402.2, R401.2, U402.9 (OUT), U402.10 (OUT); also elsewhere on the board
+2V5: C406.1, C409.2, L402.1, R406.2, U402.1 (IN), U402.2 (IN), U402.5 (EN); also elsewhere on the board
+3V3: C404.2, C405.1, L401.1, NT3.1, R402.2; also elsewhere on the board
+5V: C403.1, C408.1, R405.1, U401.4 (~SHDN), U401.5 (VIN), U403.4 (~SHDN), U403.5 (VIN); also elsewhere on the board
GND: C402.1, C403.2, C404.1, C405.2, C406.2, C408.2, C409.1, D401.2 (A), D402.1 (K), D403.2 (A), R403.1, R404.1, R407.1, U401.2 (GND), U402.6 (GND), U402.11 (EP), U403.2 (GND); also elsewhere on the board
unnamed: C401.2, D401.1 (K), L401.2, U401.6 (SW)
unnamed: D402.2 (A), R405.2
unnamed: C407.2, D403.1 (K), L402.2, U403.6 (SW)
unnamed: C401.1, U401.1 (CB)
unnamed: R402.1, R404.2, U401.3 (FB)
unnamed: NT3.2, U402.4 (BIAS)
unnamed: R401.1, R403.2, U402.8 (FB)
unnamed: C407.1, U403.1 (CB)
unnamed: R406.1, R407.2, U403.3 (FB)

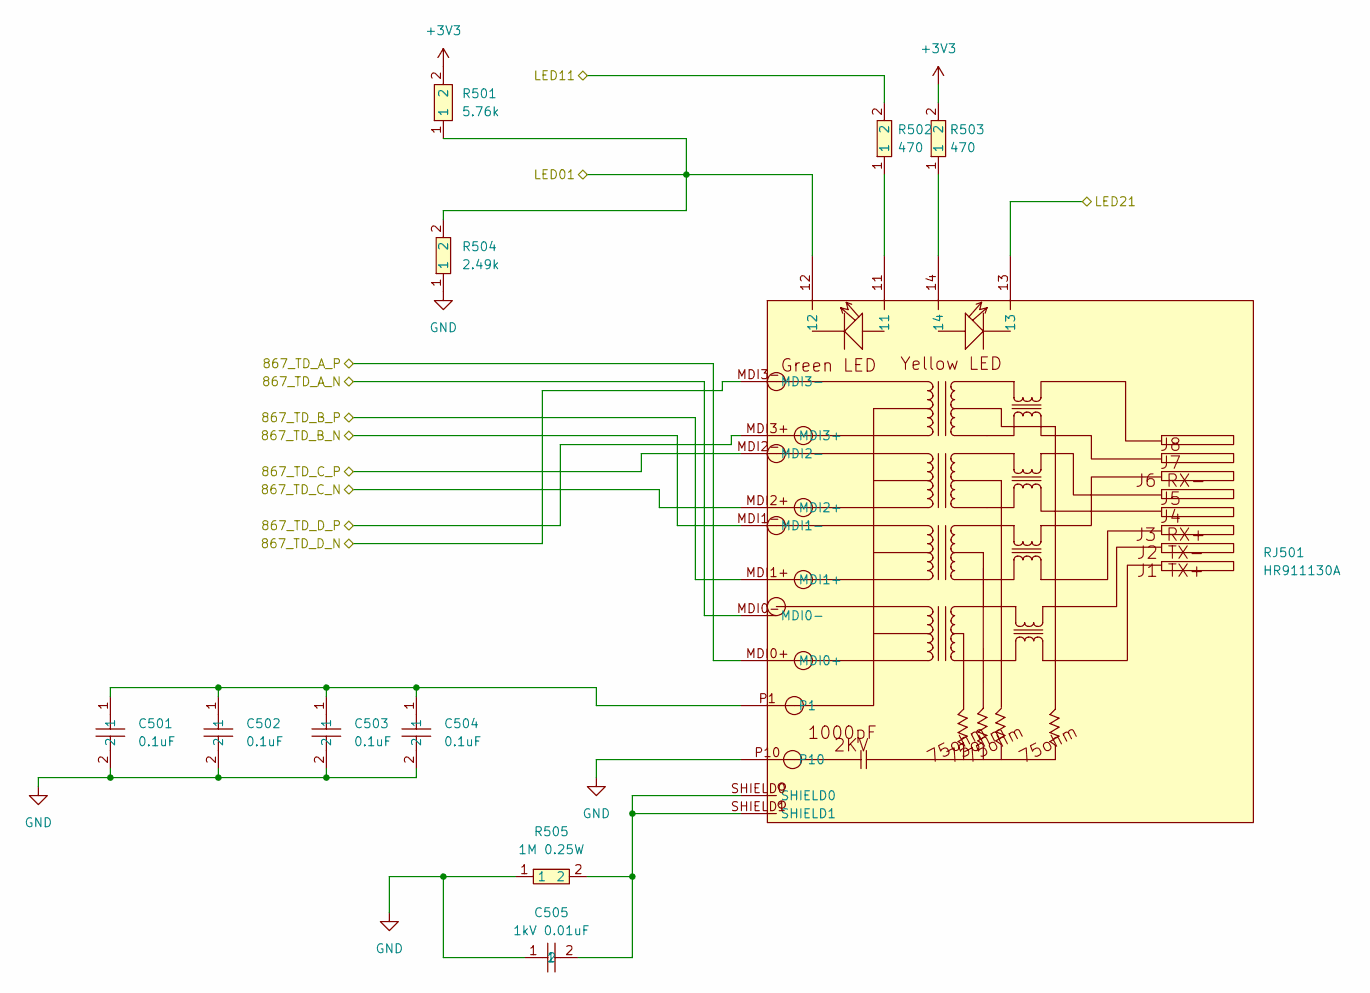
[picture p20: schematic RJ45.kicad_sch]

Parts:
C501, C502, C503, C504: 0.1uF; C0603; LCSC Part C14663
C505: 1kV 0.01uF; C1206; LCSC Part C107192
R501: 5.76k; R0603; LCSC Part C23070
R502, R503: 470; R0603; LCSC Part C23179
R504: 2.49k; R0603; LCSC Part C22908
R505: 1M 0.25W; R1206; LCSC Part C108083
RJ501: HR911130A; RJ45-TH_HR911130A; MPN HR911130A; LCSC Part C54408

Connections:
+3V3: R501.2, R503.2; also elsewhere on the board
/DP83867/867_TD_A_N: RJ501.MDI0-; also elsewhere on the board
/DP83867/867_TD_A_P: RJ501.MDI0+; also elsewhere on the board
/DP83867/867_TD_B_N: RJ501.MDI1-; also elsewhere on the board
/DP83867/867_TD_B_P: RJ501.MDI1+; also elsewhere on the board
/DP83867/867_TD_C_N: RJ501.MDI2+; also elsewhere on the board
/DP83867/867_TD_C_P: RJ501.MDI2-; also elsewhere on the board
/DP83867/867_TD_D_N: RJ501.MDI3-; also elsewhere on the board
/DP83867/867_TD_D_P: RJ501.MDI3+; also elsewhere on the board
/DP83867/LED01: R501.1, R504.2, RJ501.12; also elsewhere on the board
/DP83867/LED11: R502.2; also elsewhere on the board
/DP83867/LED21: RJ501.13; also elsewhere on the board
GND: C501.2, C502.2, C503.2, C504.2, C505.1, R504.1, R505.1, RJ501.P10; also elsewhere on the board
unnamed: C501.1, C502.1, C503.1, C504.1, RJ501.P1
unnamed: C505.2, R505.2, RJ501.SHIELD0, RJ501.SHIELD1
unnamed: R502.1, RJ501.11
unnamed: R503.1, RJ501.14

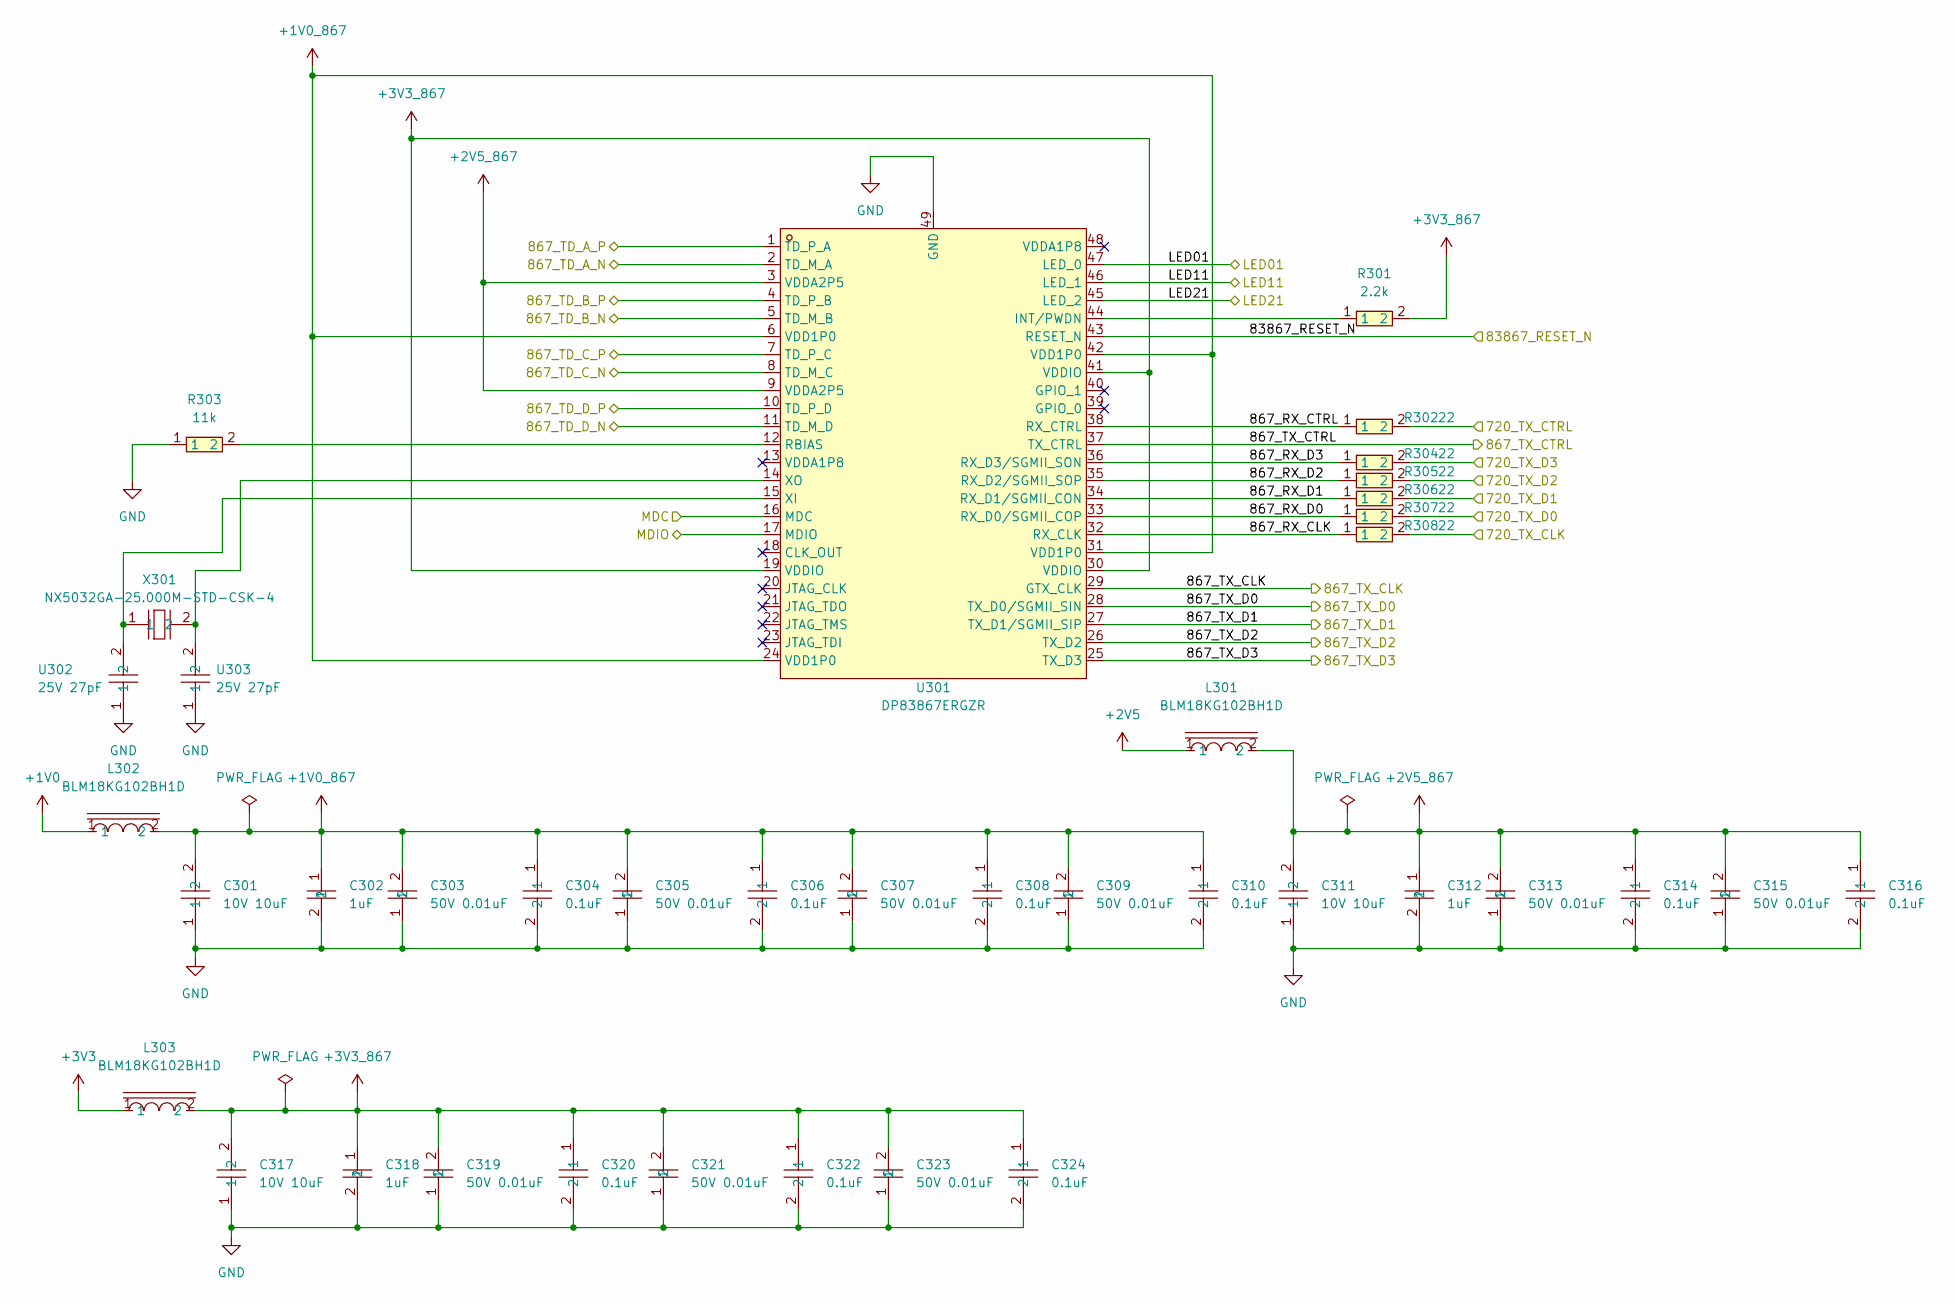
[picture p21: schematic DP83867.kicad_sch]

Parts:
C301, C311, C317: 10V 10uF; C0603; MPN GRM188Z71A106MA73D; LCSC Part C237435
C302, C312, C318: 1uF; C0603; LCSC Part C15849
C303, C305, C307, C309, C313, C315, C319, C321, C323: 50V 0.01uF; C0603; LCSC Part C57112
C304, C306, C308, C310, C314, C316, C320, C322, C324: 0.1uF; C0603; LCSC Part C14663
L301, L302, L303: BLM18KG102BH1D; L0603; MPN BLM18KG102BH1D; LCSC Part C560058
R301: 2.2k; R0603; LCSC Part C4190
R302, R304, R305, R306, R307, R308: 22; R0603; LCSC Part C108405
R303: 11k; R0603; LCSC Part C137801
U301: DP83867ERGZR; VQFN-48_L7.0-W7.0-P0.50-BL-EP4.1; MPN DP83867ERGZR; LCSC Part C913839
U302, U303: 25V 27pF; C0603; LCSC Part C1656
X301: NX5032GA-25.000M-STD-CSK-4; OSC-SMD_L5.0-W3.2; MPN NX5032GA-25.000M-STD-CSK-4; LCSC Part C115092

Connections:
+1V0: L302.1; also elsewhere on the board
+1V0_867: C301.2, C302.1, C303.2, C304.1, C305.2, C306.1, C307.2, C308.1, C309.2, C310.1, L302.2, U301.6 (VDD1P0), U301.24 (VDD1P0), U301.31 (VDD1P0), U301.42 (VDD1P0)
+2V5: L301.1; also elsewhere on the board
+2V5_867: C311.2, C312.1, C313.2, C314.1, C315.2, C316.1, L301.2, U301.3 (VDDA2P5), U301.9 (VDDA2P5)
+3V3: L303.1; also elsewhere on the board
+3V3_867: C317.2, C318.1, C319.2, C320.1, C321.2, C322.1, C323.2, C324.1, L303.2, R301.2, U301.19 (VDDIO), U301.30 (VDDIO), U301.41 (VDDIO)
/DP83867/720_TX_CLK: R308.2; also elsewhere on the board
/DP83867/720_TX_CTRL: R302.2; also elsewhere on the board
/DP83867/720_TX_D0: R307.2; also elsewhere on the board
/DP83867/720_TX_D1: R306.2; also elsewhere on the board
/DP83867/720_TX_D2: R305.2; also elsewhere on the board
/DP83867/720_TX_D3: R304.2; also elsewhere on the board
/DP83867/867_RX_CLK: R308.1, U301.32 (RX_CLK)
/DP83867/867_RX_CTRL: R302.1, U301.38 (RX_CTRL)
/DP83867/867_RX_D0: R307.1, U301.33 (RX_D0/SGMII_COP)
/DP83867/867_RX_D1: R306.1, U301.34 (RX_D1/SGMII_CON)
/DP83867/867_RX_D2: R305.1, U301.35 (RX_D2/SGMII_SOP)
/DP83867/867_RX_D3: R304.1, U301.36 (RX_D3/SGMII_SON)
/DP83867/867_TD_A_N: U301.2 (TD_M_A); also elsewhere on the board
/DP83867/867_TD_A_P: U301.1 (TD_P_A); also elsewhere on the board
/DP83867/867_TD_B_N: U301.5 (TD_M_B); also elsewhere on the board
/DP83867/867_TD_B_P: U301.4 (TD_P_B); also elsewhere on the board
/DP83867/867_TD_C_N: U301.8 (TD_M_C); also elsewhere on the board
/DP83867/867_TD_C_P: U301.7 (TD_P_C); also elsewhere on the board
/DP83867/867_TD_D_N: U301.11 (TD_M_D); also elsewhere on the board
/DP83867/867_TD_D_P: U301.10 (TD_P_D); also elsewhere on the board
/DP83867/867_TX_CLK: U301.29 (GTX_CLK); also elsewhere on the board
/DP83867/867_TX_CTRL: U301.37 (TX_CTRL); also elsewhere on the board
/DP83867/867_TX_D0: U301.28 (TX_D0/SGMII_SIN); also elsewhere on the board
/DP83867/867_TX_D1: U301.27 (TX_D1/SGMII_SIP); also elsewhere on the board
/DP83867/867_TX_D2: U301.26 (TX_D2); also elsewhere on the board
/DP83867/867_TX_D3: U301.25 (TX_D3); also elsewhere on the board
/DP83867/83867_RESET_N: U301.43 (RESET_N); also elsewhere on the board
/DP83867/LED01: U301.47 (LED_0); also elsewhere on the board
/DP83867/LED11: U301.46 (LED_1); also elsewhere on the board
/DP83867/LED21: U301.45 (LED_2); also elsewhere on the board
/DP83867/MDC: U301.16 (MDC); also elsewhere on the board
/DP83867/MDIO: U301.17 (MDIO); also elsewhere on the board
GND: C301.1, C302.2, C303.1, C304.2, C305.1, C306.2, C307.1, C308.2, C309.1, C310.2, C311.1, C312.2, C313.1, C314.2, C315.1, C316.2, C317.1, C318.2, C319.1, C320.2, C321.1, C322.2, C323.1, C324.2, R303.1, U301.49 (GND), U302.1, U303.1; also elsewhere on the board
unnamed: R301.1, U301.44 (INT/PWDN)
unnamed: R303.2, U301.12 (RBIAS)
unnamed: U301.15 (XI), U302.2, X301.1
unnamed: U301.14 (XO), U303.2, X301.2

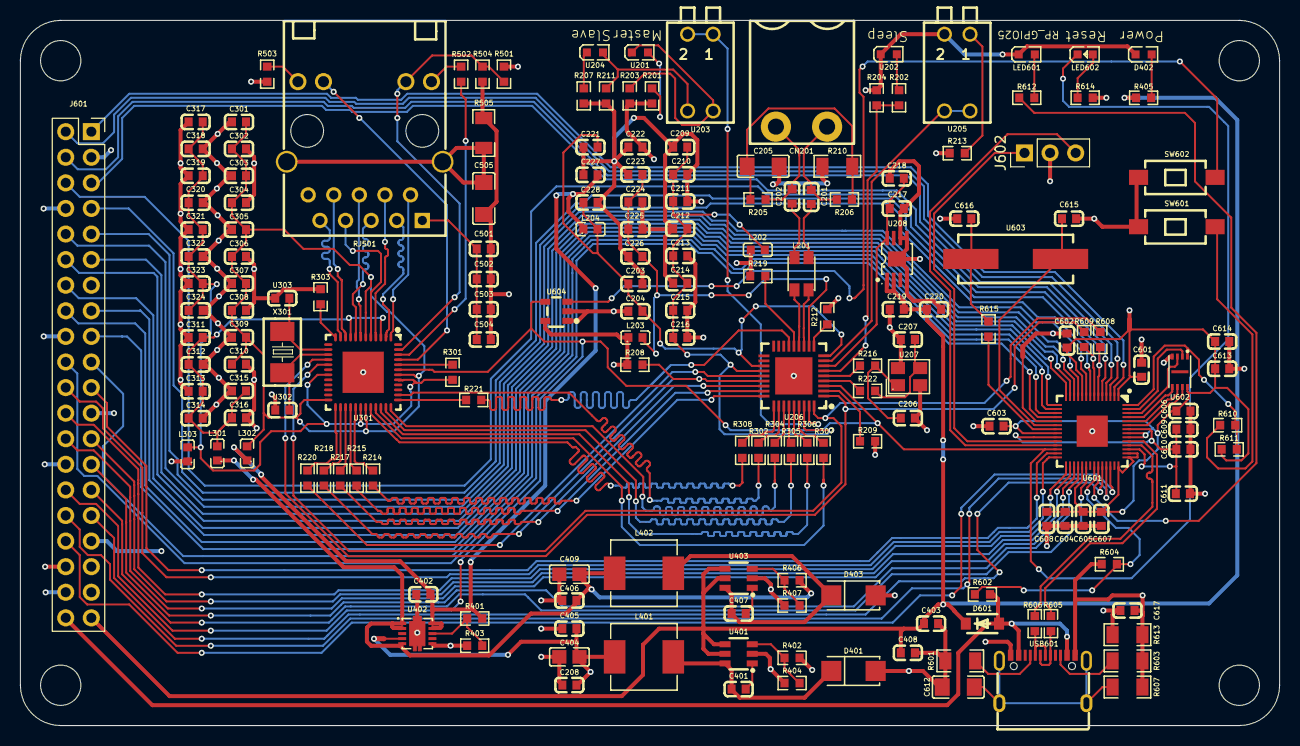
[picture p22: board 1000base-t1-converter.kicad_pcb from above]

Board: 4 copper layers, 125.0 x 70.0 mm, 184 parts (0 on the bottom side), 144 nets.
