TLDSJPWORK/1000base-t1-converter/(commit log)

2026-10-04 Initial public hardware release
    [1000base-t1-converter-B_Cu.gbl, 1000base-t1-converter-B_Mask.gbs, 1000base-t1-converter-B_Paste.gbp, 1000base-t1-converter-B_Silkscreen.gbo, 1000base-t1-converter-Edge_Cuts.gm1, 1000base-t1-converter-F_Cu.gtl, 1000base-t1-converter-F_Mask.gts, 1000base-t1-converter-F_Paste.gtp]
2026-10-27 Publish Rev1.0 hardware, manual and MATEnet adapter
    [1000base-t1-converter-B_Cu.gbl, 1000base-t1-converter-B_Mask.gbs, 1000base-t1-converter-B_Paste.gbp, 1000base-t1-converter-B_Silkscreen.gbo, 1000base-t1-converter-Edge_Cuts.gm1, 1000base-t1-converter-F_Cu.gtl, 1000base-t1-converter-F_Mask.gts, 1000base-t1-converter-F_Paste.gtp]
